AlphaCompLabs/H-Drop/README.md

<div align="center">

# H-DROP

### Veículo de Superfície Autônomo para Logística Humanitária

<br>

<p>
  
  &nbsp;&nbsp;
  
  &nbsp;&nbsp;
  
  <br><br>
  
  &nbsp;&nbsp;
  
  &nbsp;&nbsp;
  
  &nbsp;&nbsp;
  
</p>

<p>
  <strong>Projeto H-DROP · Relatório PC1 · 2026</strong>
</p>

</div>

---

## Sobre o Projeto

O **H-DROP** é um **Veículo de Superfície Autônomo (ASV)** do tipo catamarã, dundamentado no conceito de Dual-use: uma plataforma versátil projetada para atuar na logística humanitária — atendendo populações isoladas e cenários pós-desastre — e no delivery comercial de última milha (last-mile) em canais urbanos e condomínios náuticos. A embarcação é tracionada por propulsão diferencial via **motores brushless** e gerenciada por um sistema embarcado **ESP32** sob o sistema operacional de tempo real FreeRTOS, garantindo processamento assíncrono para navegação autônoma e telemetria via rede **4G LTE**. A infraestrutura de controle opera como uma Estação de Controle de Missão (GCS), permitindo o monitoramento tático de subsistemas e o despacho dinâmico de waypoints através de uma arquitetura baseada em **FastAPI e Angular**.

### Objetivos

- **Versatilidade Operacional (Dual-use):** Automatizar o transporte aquático de cargas, alternando entre o suporte emergencial de insumos vitais e a distribuição comercial rotineira por rotas programáveis.
- **Monitoramento e Consciência Situacional:** Implementar o rastreio em tempo real de coordenadas GNSS, proa magnética absoluta e telemetria energética baseada em Lógica Fuzzy e Contagem de Coulomb.
- **Gestão Logística Inteligente:** Validar o ciclo completo de entrega através de detecção binária de carga e fornecer uma interface tática (Mission Control) otimizada para dispositivos móveis em campo.
- **Segurança e Confiabilidade:** Mitigar riscos operacionais via sistemas de proteção anticolisão e protocolos de preservação de hardware, garantindo a integridade da carga e a estabilidade do sistema sob perturbações ambientais.

---

## Arquitetura da Solução

O sistema é composto por três camadas independentes que se comunicam via protocolo MQTT e WebSocket:

```
├── 📁 BackEnd
│   ├── 📁 src
│   │   ├── 📁 api
│   │   │   ├── 📁 v1
│   │   │   │   ├── 📁 routes
│   │   │   │   │   ├── 🐍 __init__.py
│   │   │   │   │   ├── 🐍 comando.py
│   │   │   │   │   ├── 🐍 health.py
│   │   │   │   │   └── 🐍 telemetria.py
│   │   │   │   ├── 🐍 __init__.py
│   │   │   │   └── 🐍 router.py
│   │   │   └── 🐍 __init__.py
│   │   ├── 📁 core
│   │   │   ├── 🐍 __init__.py
│   │   │   ├── 🐍 config.py
│   │   │   ├── 🐍 lifespan.py
│   │   │   └── 🐍 logging.py
│   │   ├── 📁 models
│   │   │   └── 🐍 __init__.py
│   │   ├── 📁 schemas
│   │   │   ├── 🐍 __init__.py
│   │   │   ├── 🐍 comando.py
│   │   │   └── 🐍 telemetria.py
│   │   ├── 📁 services
│   │   │   ├── 🐍 __init__.py
│   │   │   ├── 🐍 mqtt_service.py
│   │   │   ├── 🐍 telemetria_service.py
│   │   │   └── 🐍 websocket_manager.py
│   │   ├── 📁 utils
│   │   │   ├── 🐍 __init__.py
│   │   │   ├── 🐍 geo.py
│   │   │   └── 🐍 sensores.py
│   │   └── 🐍 __init__.py
│   ├── ⚙️ .env.example
│   ├── ⚙️ .gitignore
│   ├── 📝 README.md
│   ├── 🐍 main.py
│   └── 📄 requirements.txt
├── 📁 Controler-Simulation
│   ├── 📁 .devcontainer
│   ├── 📁 .vscode
│   │   ├── {} c_cpp_properties.json
│   │   ├── {} launch.json
│   │   └── {} settings.json
│   ├── 📁 main
│   │   ├── 🔺 CMakeLists.txt
│   │   ├── 🅒 main.c
│   │   └── 📝 README.md
│   ├── 🔺 CMakeLists.txt
│   ├── 🌐 dashboard.html
│   ├── 🐍 hdrop_sim.py
│   └── 📝 PIPELINE.md
├── 📁 Docs
│   ├── 📕 REACT LIVRO.pdf
│   ├── 📝 README.md
│   ├── 📕 Relatório PC1.pdf
│   ├── 📕 Subsistema_Comunicação_Posicionamento_Módulo_4G_GNSS_TCC.pdf
│   ├── 📕 Subsistema_Controlador_TCC (1).pdf
│   ├── 📕 Subsistema_de_Alimentação_TCC (1).pdf
│   ├── 🖼️ WhatsApp Image 2026-03-01 at 10.31.07.jpeg
│   └── 📕 roteiro_proposta_projeto.pdf
├── 📁 FrontEnd
│   ├── 📁 .angular
│   ├── 📁 src
│   │   ├── 📁 app
│   │   │   ├── 📁 core
│   │   │   │   ├── 📁 models
│   │   │   │   │   ├── 📄 alerta.model.ts
│   │   │   │   │   ├── 📄 comando.model.ts
│   │   │   │   │   ├── 📄 status.model.ts
│   │   │   │   │   └── 📄 telemetria.model.ts
│   │   │   │   └── 📁 services
│   │   │   │       ├── 📄 alerts.service.ts
│   │   │   │       ├── 📄 comando.service.ts
│   │   │   │       ├── 📄 geo.util.ts
│   │   │   │       ├── 📄 telemetria.service.ts
│   │   │   │       └── 📄 theme.service.ts
│   │   │   ├── 📁 features
│   │   │   │   ├── 📁 map
│   │   │   │   │   ├── 🎨 map.component.scss
│   │   │   │   │   └── 📄 map.component.ts
│   │   │   │   ├── 📁 mission-control
│   │   │   │   │   ├── 🎨 mission-control.component.scss
│   │   │   │   │   └── 📄 mission-control.component.ts
│   │   │   │   ├── 📁 sidebar
│   │   │   │   │   ├── 🎨 sidebar.component.scss
│   │   │   │   │   └── 📄 sidebar.component.ts
│   │   │   │   └── 📁 sync-test
│   │   │   │       ├── 🎨 sync-test.component.scss
│   │   │   │       └── 📄 sync-test.component.ts
│   │   │   ├── 📁 shared
│   │   │   │   └── 📁 components
│   │   │   │       ├── 📁 alert-overlay
│   │   │   │       │   ├── 🎨 alert-overlay.component.scss
│   │   │   │       │   └── 📄 alert-overlay.component.ts
│   │   │   │       ├── 📁 compass
│   │   │   │       │   ├── 🎨 compass.component.scss
│   │   │   │       │   └── 📄 compass.component.ts
│   │   │   │       ├── 📁 status-bar
│   │   │   │       │   ├── 🎨 status-bar.component.scss
│   │   │   │       │   └── 📄 status-bar.component.ts
│   │   │   │       ├── 📁 telemetry-card
│   │   │   │       │   ├── 🎨 telemetry-card.component.scss
│   │   │   │       │   └── 📄 telemetry-card.component.ts
│   │   │   │       └── 📁 theme-toggle
│   │   │   │           └── 📄 theme-toggle.component.ts
│   │   │   ├── 📄 app.component.ts
│   │   │   ├── 📄 app.config.ts
│   │   │   └── 📄 app.routes.ts
│   │   ├── 📁 assets
│   │   │   ├── 📁 favicon
│   │   │   │   └── 📝 README.md
│   │   │   └── 📁 images
│   │   │       ├── 📝 README.md
│   │   │       ├── 🖼️ logo-hdrop-dark.png
│   │   │       └── 🖼️ logo-hdrop-light.png
│   │   ├── 📁 environments
│   │   │   ├── 📄 environment.prod.ts
│   │   │   └── 📄 environment.ts
│   │   ├── 🌐 index.html
│   │   ├── 📄 main.ts
│   │   └── 🎨 styles.scss
│   ├── ⚙️ .gitignore
│   ├── 📝 README.md
│   ├── ⚙️ angular.json
│   ├── ⚙️ package-lock.json
│   ├── ⚙️ package.json
│   ├── ⚙️ tsconfig.app.json
│   └── ⚙️ tsconfig.json
├── 📁 GPS
│   ├── 📝 README.md
│   └── 📄 hdrop_barco_autonomo.ino
├── 📁 Motors-Simulation
│   └── 📄 firmware-motores.ino
├── 📁 Sensor
│   ├── 📁 include
│   │   └── 📄 README
│   ├── 📁 lib
│   │   └── 📄 README
│   ├── 📁 src
│   │   └── ⚡ main.cpp
│   ├── 📁 test
│   │   └── 📄 README
│   ├── ⚙️ .gitignore
│   ├── 📝 README.md
│   └── ⚙️ platformio.ini
└── 📝 README.md
```

### Fluxo de Dados

```
┌──────────────┐      MQTT       ┌──────────────┐    WebSocket    ┌──────────────┐
│   ESP32      │ ─────────────▶  │   Backend    │ ──────────────▶ │   Angular    │
│   + GNSS     │   hdrop/raw     │   FastAPI    │  /ws/telemetria │   Dashboard  │
│   + Magnet.  │ ◀─────────────  │   (Hub)      │ ◀────────────── │   (Operador) │
└──────────────┘  hdrop/comando  └──────────────┘   POST /comando └──────────────┘
                                         │
                                         ▼
                                 hdrop/telemetria
                                 (eco processado)
```

1. O ESP32 publica telemetria bruta (string NMEA + vetor do magnetômetro) no tópico **`hdrop/raw`**.
2. O backend processa em tempo real — calcula a proa calibrada e extrai coordenadas GPS — e re-publica o resultado limpo em **`hdrop/telemetria`**, simultaneamente fazendo broadcast via **WebSocket** para todos os operadores conectados.
3. O operador clica no mapa, o frontend envia **`POST /api/v1/comando`** ao backend, que publica a coordenada em **`hdrop/comando`** — o ESP32 recebe e recalcula a rota.

---

## Subsistemas Monitorados (Relatório PC1)

| Subsistema | Hardware | Responsabilidade |
|:---|:---|:---|
| **Controle Embarcado** | ESP32 | Orquestração de sensores, atuação dos motores, comunicação MQTT |
| **Posicionamento** | GNSS + A7670SA | Geolocalização via constelação de satélites + fix assistido |
| **Comunicação** | A7670SA (4G LTE) | Uplink de telemetria e downlink de comandos através de broker MQTT |
| **Navegação** | Magnetômetro calibrado | Determinação de proa magnética (0°–360°) |
| **Propulsão** | 2× motores brushless | Controle diferencial para avanço, ré e curvas |
| **Energia** | LiFePO4 + INA226 | Monitoramento de tensão, corrente e SoC da bateria |
| **Carga Útil** | Célula de carga HX711 | Detecção de compartimento ocupado/vazio |

---

## Início Rápido

### Pré-requisitos

- **Python 3.11+** e pip
- **Node.js 20+** e npm
- Conexão à internet (para alcançar o broker público `broker.hivemq.com`)

### 1. Iniciar o Backend

```bash
cd BackEnd
python -m venv venv
venv\Scripts\activate          # Windows
# source venv/bin/activate     # Linux/macOS
pip install -r requirements.txt
copy .env.example .env         # Windows
# cp .env.example .env         # Linux/macOS
python main.py
```

API disponível em **`http://localhost:8000`** · Swagger em **`http://localhost:8000/docs`**

### 2. Iniciar o Frontend

```bash
cd FrontEnd
npm install
npm start
```

Mission Control disponível em **`http://localhost:4200`**

### 3. Simular Telemetria do ESP32 (opcional)

Sem o hardware em mãos, você pode publicar mensagens diretamente no broker usando `mosquitto_pub` ou qualquer cliente MQTT:

```bash
mosquitto_pub -h broker.hivemq.com -t hdrop/raw \
  -m '{"g":",,,,,-15.87500,S,-48.08500,W,...","m":[1700,150,0]}'
```

O dashboard deve atualizar a posição e a proa em tempo real.

### 4. Executar a Simulação do Controlador

O módulo `Controler-Simulation` permite validar a lógica de navegação e controle PID sem o hardware embarcado. Requer o ESP-IDF instalado e configurado.

```bash
cd Controler-Simulation
idf.py build
idf.py flash monitor   # com hardware conectado
# ou execute hdrop_sim.py para simulação em Python
python hdrop_sim.py
```

O dashboard de simulação pode ser acessado abrindo `dashboard.html` diretamente no navegador. Consulte `PIPELINE.md` para detalhes do fluxo de simulação.

### 5. Carregar o Firmware dos Motores

O módulo `Motors-Simulation` contém o firmware de controle dos ESCs para validação da propulsão diferencial via interface web, desenvolvido no Arduino IDE.

```
Pré-requisitos:
- Arduino IDE 2.x
- Biblioteca ESP32Servo instalada (Gerenciador de Bibliotecas)
- Placa: ESP32 Dev Module
```

```bash
# 1. Abra o arquivo no Arduino IDE:
Motors-Simulation/firmware-motores.ino

# 2. Edite as credenciais Wi-Fi no início do arquivo:
const char* ssid     = "NOME_DA_SUA_REDE";
const char* password = "SENHA_DA_SUA_REDE";

# 3. Selecione a porta COM correta e faça o upload
```

Após o upload, o IP do ESP32 será exibido no Serial Monitor. Acesse esse IP pelo navegador do celular (na mesma rede) para controlar os motores individualmente via sliders PWM ou pelos botões de ré, frente e parada de emergência.

---

## Stack Tecnológica

| Camada | Tecnologia | Versão |
|:---|:---|:---|
| Framework Backend | FastAPI | 0.115+ |
| Cliente MQTT Assíncrono | aiomqtt | 2.3+ |
| Servidor ASGI | Uvicorn | 0.32+ |
| Validação de Dados | Pydantic | 2.10+ |
| Configuração | pydantic-settings | 2.7+ |
| Framework Frontend | Angular | 19+ |
| Linguagem | TypeScript | 5.6+ |
| Biblioteca de Mapas | Leaflet | 1.9+ |
| Ícones | Iconify (Phosphor Icons) | 2.1+ (via CDN) |
| Reatividade | RxJS + Angular Signals | — |
| Broker MQTT | HiveMQ (público) | — |
| Firmware Motores | Arduino IDE + ESP32Servo | 2.x |
| Simulação Controlador | ESP-IDF + Python | 5.x / 3.11+ |

---

## Identidade Visual (PC1)

A paleta **Mission Control** foi derivada do Relatório PC1 e pensada para leitura rápida em situações críticas:

| Token | Cor | Uso |
|:---|:---:|:---|
| **Critical Ocean Blue** | `#0a4d8c` | Interface principal, mapas, destaques |
| **Life-Saving Green** | `#00d66b` | Estados OK, bateria cheia, missão concluída |
| **Safety Yellow** | `#ffc233` | Avisos, proximidade de obstáculos, sync pendente |
| **Strategic Red** | `#ff3b3b` | Erros críticos, parada de emergência, bateria crítica |

Dois temas disponíveis via toggle no header: **Mission Dark** (padrão, otimizado para cabines de controle) e **Utility Light** (otimizado para luz solar direta em campo).

---

## Funcionalidades

| Status | Funcionalidade |
|:---:|:---|
| ✓ | Telemetria GPS em tempo real com suavização (média móvel de 5 pontos) |
| ✓ | Cálculo assíncrono da proa magnética com calibração de offsets |
| ✓ | Mapa Leaflet interativo com 3 camadas (dark/street/satellite) |
| ✓ | Envio de waypoints por clique no mapa (publish MQTT) |
| ✓ | WebSocket broadcast para múltiplos operadores simultâneos |
| ✓ | Dashboard responsivo com abas mobile (mapa/telemetria/sync) |
| ✓ | Aba Sync Test com comandos rápidos (START/ACK/HOME/STOP) |
| ✓ | Sistema de alertas críticos com modal bloqueante |
| ✓ | Troca dinâmica Mission Dark / Utility Light |
| ✓ | Firmware de validação da propulsão diferencial via interface web (Motors-Simulation) |
| ✓ | Simulação do controlador embarcado com dashboard e pipeline de testes (Controler-Simulation) |
| ○ | Persistência de histórico de missões (MongoDB — roadmap Fase 3) |
| ○ | Monitoramento do SoC da bateria via INA226 (firmware em desenvolvimento) |
| ○ | Detecção de carga via HX711 (firmware em desenvolvimento) |
| ○ | Autenticação e perfis de operador (roadmap) |

---

## Documentação por Módulo

| Módulo | Documentação |
|:---|:---|
| **Backend — API FastAPI + MQTT** | [BackEnd/README.md](./BackEnd/README.md) |
| **Frontend — Mission Control Angular** | [FrontEnd/README.md](./FrontEnd/README.md) |
| **Simulação do Controlador** | [Controler-Simulation/main/README.md](./Controler-Simulation/main/README.md) |
| **Firmware dos Motores** | [Motors-Simulation/](./Motors-Simulation/) |
| **Relatório PC1 e subsistemas** | [Docs/](./Docs/) |

---

<div align="center">
  <br>
  &copy; 2026 Projeto H-DROP. Todos os direitos reservados.
  <br><br>
  <em>Autonomous Surface Vehicle · Humanitarian Logistics · Mission Control</em>
</div>
