AlphaCompLabs/H-Drop/Docs/Subsistema_Controlador_TCC (1).pdf

# Subsistema Controlador

1

° Diogo Freitas Machado
Engenharia de Computaçaõ
Instituto de Educaçao Superior de Bras ˜ | ília - IESB
Brasília, DF
diogo.machado@iesb.edu.br
2312082012

2

° Elisa Nunes de Freitas
Engenharia de Computaçaõ
Instituto de Educaçao Superior de Bras ˜ | ília - IESB
Brasília, DF
elisa.freitas@iesb.edu.br
2312082040

Orientador: Paulo Henrique Moreira de Carvalho Faria
Engenharia Eletronica & Engenharia de Software ˆ
Instituto de Educaçao Superior de Bras ˜ | ília - IESB
Brasília, DF
paulo.faria@iesb.edu.br
201836
Abstract—Este documento e uma formalizaç ´ | ao das pesquisas ˜
realizadas sobre tudo o que tange a respeito do ESP32 (Controlador) para o ASV a ser desenvolvido.
Index Terms—Controle, Atuadores, ESP32, motores, RIPEAM
I. INTRODUÇ AO E ˜ ESCOPO

Uma vez estruturado o Subsistema de Alimentaçao, o ˜ proximo passo definido para o desenvolvimento do ASV foi a ´ pesquisa e estruturaçao dos subsistemas de processamento do ˜ dispositivo. O presente documento abordara especificamente ´ sobre o Subsistema Controlador e tudo o que tange a seu respeito. Dessa forma, para este documento, mencionar subsistema controlador entende-se por todas as responsabili-
dades , atuaçoes e conex ˜ | oes do ESP32 escolhido para ser o ˜
responsavel por controlar os atuadores do ASV, como motores ´ e LEDs de segurança.

II. HARDWARE DO CONTROLADOR (ESP32)
Antes de aprofundar nas responsabilidade, conexoes, etc ˜ | é
necessario conhecer o microcontrolador selecionado e suas ´ características. Sendo assim, o ESP32 foi escolhido com base nos criterios de custo, acessibilidade, facilidade de ´
implementaçao/integraç ˜ | ao e capacitaç ˜ | ao para os requisitos do ˜
projeto.
A. ESP32-WROOM-32
E o microcontrolador que suprir ´ | a todos os crit ´ | erios do ´
projeto planejado visto que ele possui um custo baixo, é um dos microcontroladores mais difundidos na comunidade
e e um m ´ | odulo poderoso e gen ´ | erico de MCU com Wi-Fi, ´
Bluetooth e Bluetooth LE alem do n ´ | ucleo deste m ´ | odulo ´
com o chip ESP32-D0WDQ6, que possui dois processadores Xtensa® de 32 bits LX6 os quais podem operar a uma
frequencia de at ˆ | e 240 MHz. ´

Principais Componentes

- Processador e Memoria: ´ O modulo conta com micro- ´ processadores dual-core Xtensa® 32-bit LX6, 448 KB de ROM, 520 KB de SRAM e 8 KB de SRAM no RTC.
Alem disso, possui 4 MB de mem ´ | oria flash SPI externa ´
integrada.
- Perifericos Integrados: ´ | O modulo disp ´ | oe de uma vasta ˜
gama de perifericos, incluindo: ´

– Ate 32 GPIOs. ´
– Interfaces como UART, SPI, SDIO, I2C, I2S e LED PWM.
– Sensores como sensor de toque capacitivo, sensor Hall, ADC (Conversor Analogico-Digital) e DAC ´ (Conversor Digital-Analogico). ´
– Contador de pulsos e controlador TWAI® (compatível com ISO 11898-1, especificaçao CAN 2.0). ˜ – Interface Ethernet MAC para comunicaçoes LAN. ˜
- Relogio e Cristal: ´ | Possui um oscilador de cristal de 40
MHz integrado.

Por fim, este ESP possui algumas funcionalidades de destaque como Gerenciamento de Energia com diferentes modos de energia, Segurança e Boot com pinos de strapping e
bits eFuse alem de possuir uma gama variada de aplicaç ´ | | oes.E ˜
de todos estes componentes e funcionalidades, os mais utiliza-
dos neste sistema serao o perif ˜ | erico MCPWM, o perif ´ | erico ´
LEDC, as interfaces UART, a interface I2C, os GPIOs e principalmente os nucleos processadores Xtensa®. ´

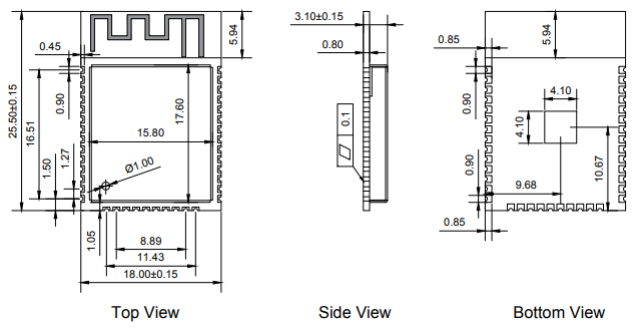
[picture p17: figure]

Fig. 1: Dimensoes do ESP32-WROOM-32 ˜

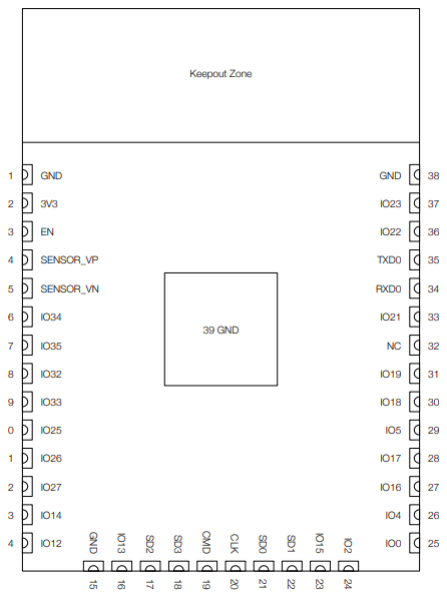
[picture p18: figure]

Fig. 2: Layout de Pinos do ESP32-WROOM-32

Observaçao.: ˜ Pretende-se utilizar o ESP32 ja no modelo ´ DEV KIT em uma placa PCB para maior simplicidade do projeto.

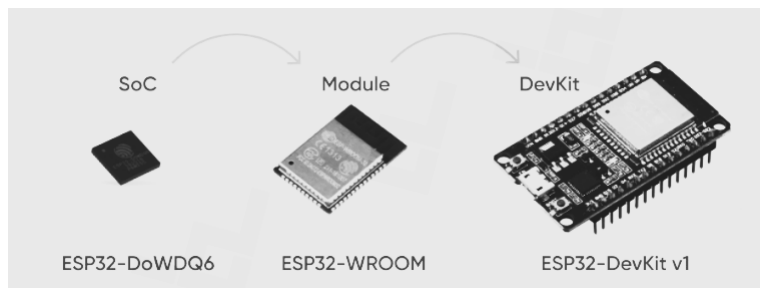
[picture p19: figure]

Fig. 3: Explicaçao visual do DEV KIT ˜

B. Restriçoes de Hardware e Seleç ˜ | ao Segura de GPIOs ˜
Embora o ESP32 ofereça uma ampla gama de pinos de entrada e saída (GPIOs), a seleçao para o controle de atu- ˜ adores críticos (como motores e luzes RIPEAM) nao pode ˜
ser arbitraria. Existem grupos de pinos com funç ´ | oes especiais ˜
de inicializaçao ( ˜ | boot) e restriçoes el ˜ | etricas que, se ignoradas, ´
podem impedir a inicializaçao do sistema ou causar falhas ˜ intermitentes.

Pinos de Strapping (Strapping Pins): O ESP32 possui 5 pinos de strapping: GPIO 0, 2, 5, 12 e 15. Durante a
inicializaçao (fase de ˜ | Power-On Reset), o chip amostra o nível
de tensao nestes pinos para decidir par ˜ | ametros cr ˆ | íticos:
- Modo de Boot: O GPIO 0 deve estar em nível ALTO para iniciar o firmware normalmente. Se estiver BAIXO,
o chip entra em modo de gravaçao ( ˜ | Download Mode).
- Tensao da Flash (VDD ˜ | SDIO): O GPIO 12 controla
a tensao do regulador interno (1.8V ou 3.3V). Se um ˜ circuito externo puxar este pino para o nível errado durante o boot, o processador pode sofrer Brownout e nao iniciar. ˜
- Logs de Debug: O GPIO 15 controla as mensagens de log na serial durante o boot.
Devido a essas características, o projeto do subsistema de controle evitou conectar drivers de baixa impedancia ou ˆ resistores de pull-up/pull-down fortes nestes pinos, priorizando o uso de GPIOs ”seguros” (como 16, 17, 18, 19 e 21 a 23) para o controle dos motores e comunicaçao. ˜
Pinos de Entrada Exclusiva (Input-Only): Os pinos GPIO 34, 35, 36 (VP) e 39 (VN) nao possuem circuitos ˜ de saída push-pull, funcionando apenas como entradas digitais ou analogicas. No projeto, estes pinos foram reservados ´ estritamente para leitura de sensores (como monitoramento de tensao da bateria via ADC), evitando seu uso para controle de ˜ LEDs ou ativaçao de MOSFETs. ˜
Pinos Reservados a Flash SPI ` | : Os pinos GPIO 6 ao
11 estao conectados internamente ˜ | a mem ` | oria Flash integrada ´
do modulo ESP32-WROOM-32. O uso destes pinos para ´ qualquer periferico externo causaria conflito no barramento ´ SPI, travando o sistema imediatamente.

TABLE I: Mapeamento de Segurança dos GPIOs Selecionados

Grupo | GPIOs | Decisao de Projeto ˜
Strapping | 0, 2, 5, 12, 15 | Evitados para saídas críticas (PWM/Mo-tores) para garantir boot seguro.
Flash SPI | 6 – 11 | Nao utilizados ˜ (Conectados a mem ` oria ´ flash interna).
Input Only | 34 – 39 | Reservados estritamente para Sensores (AD-C/Feedback).
Safe I/O | 16, 17, 18, 19 | Alocados para perifericos ativos (UART, ´ PWM e RIPEAM).
III. ALIMENTAÇ AO E ˜ | PROTEÇ AÕ ELETRICA ´
Atraves | dos | reguladores | Buck do | Subsistema | de ´
Alimentaçao, ser ˜ | a feita a conex ´ | ao ao pino de alimentaç ˜ | aõ
(Vin) OU diretamente ao pino de 3V3 que permitira a ativaç ´ | aõ
e funcionamento constanste do ESP32.

IV. ARQUITETURA DE SOFTWARE (RTOS)

Diferentemente de arquiteturas de super-loop (execuçaõ sequencial unica) comuns em microcontroladores de 8 bits, o ´ subsistema de controle do ASV exige a execuçao concorrente ˜ de tarefas com requisitos temporais distintos: a malha de controle PID deve ser estritamente determinística, enquanto
a interpretaçao de comandos via UART ˜ | e orientada a eventos ´
e assíncrona.

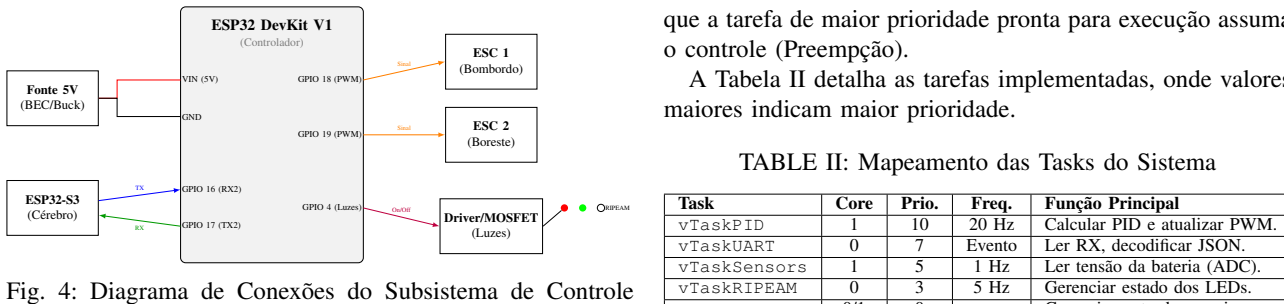
[picture p20: figure]
ESP32 DevKit V1; (Controlador); VIN (5V); GND; GPIO 16 (RX2); GPIO 17 (TX2); GPIO 18 (PWM); GPIO 19 (PWM); GPIO 4 (Luzes); Fonte 5V (BEC/Buck); ESP32-S3 (Cerebro) ´; ESC 1 (Bombordo) Sinal; ESC 2 (Boreste); Sinal; Driver/MOSFET (Luzes); On/Off; RIPEAM; o controle (Preempçao). ˜; maiores indicam maior prioridade.; Task; Core; Prio.; Freq.; Funçao Principal ˜; vTaskPID; Calcular PID e atualizar PWM.; vTaskUART; Evento; Ler RX, decodificar JSON.; vTaskRIPEAM; Gerenciar estado dos LEDs.

Fig. 4: Diagrama de Conexoes do Subsistema de Controle ˜ (DevKit).

Para gerenciar essa complexidade, utiliza-se o FreeRTOS (Real-Time Operating System), nativo do framework de desenvolvimento do ESP32. O sistema operacional gerencia o escalonamento das tarefas (Tasks), permitindo preempçaõ baseada em prioridades e o uso eficiente dos dois nucleos de ´ processamento do ESP32-D0WDQ6.

A. Estrategia de Multiprocessamento Assim ´ | | etrico (AMP) ´
O ESP32 possui dois nucleos Xtensa® LX6 de 32 bits. ´ Para maximizar a estabilidade da navegaçao, adotou-se uma ˜
estrategia de segregaç ´ | ao de responsabilidades: ˜
- Core 0 (Protocol CPU - PRO CPU): Dedicado as` tarefas de ”infraestrutura” e comunicaçao. Ele gerencia ˜ a pilha Wi-Fi/Bluetooth (se ativa), o monitoramento do sistema (Watchdog) e o processamento de pacotes da
UART. Interrupçoes de comunicaç ˜ | ao s ˜ | ao tratadas aqui ˜
para nao inserir ˜ | jitter (ruído temporal) no controle.
- Core 1 (Application CPU - APP CPU): Dedicado
exclusivamente a matem ` | atica de controle e atuaç ´ | ao. A ˜
Task do PID roda isolada neste nucleo, garantindo que ´ o calculo das integrais e derivadas ocorra em intervalos ´ precisos (Ts = 50ms), imune a atrasos causados pelo processamento de strings ou logs de sistema.
A Figura 5 ilustra essa distribuiçao de carga. ˜

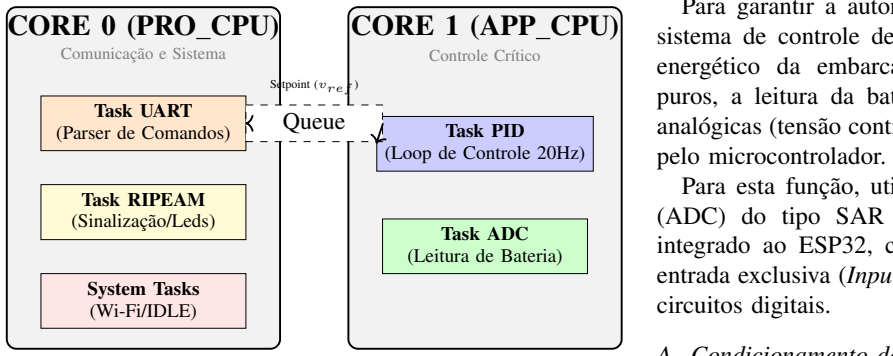
[picture p21: figure]
CORE 0 (PRO CPU); Comunicaçao e Sistema ˜; Task UART (Parser de Comandos); Task RIPEAM (Sinalizaçao/Leds) ˜; System Tasks (Wi-Fi/IDLE); CORE 1 (APP CPU); Controle Crítico; Task PID (Loop de Controle 20Hz); Task ADC (Leitura de Bateria); Queue; Setpoint (vref ); pelo microcontrolador.; circuitos digitais.

Fig. 5: Arquitetura de Software: Alocaçao de tarefas nos ˜ nucleos do ESP32. ´

B. Definiçao e Priorizaç ˜ | ao de Tarefas ˜
No FreeRTOS, a prioridade determina qual tarefa tem
preferencia de uso da CPU. O escalonador ( ˆ | Scheduler) garante

que a tarefa de maior prioridade pronta para execuçao assuma ˜

A Tabela II detalha as tarefas implementadas, onde valores

TABLE II: Mapeamento das Tasks do Sistema

vTaskSensors | 1 | 5 | 1 Hz | Ler tensao da bateria (ADC). ˜
IDLE | 0/1 | 0 | - | Gerenciamento de energia.
A vTaskPID | possui a prioridade mais alta no
Core 1 para garantir determinismo. Utiliza-se a funçaõ vTaskDelayUntil() para assegurar que o período de amostragem seja exato, compensando o tempo de execuçaõ
do proprio algoritmo matem ´ | atico. ´
C. Sincronizaçao e Comunicaç ˜ | ao Inter-Processos (IPC) ˜
Como as tarefas rodam em nucleos diferentes, elas n ´ | ao po- ˜
dem simplesmente acessar variaveis globais simultaneamente ´
sem risco de corrupçao de mem ˜ | oria ( ´ | Race Condition).
A troca de dados entre a recepçao de comandos (Core 0) e ˜
o controle (Core 1) e realizada atrav ´ | es de ´ | Filas do FreeRTOS
(Queues).
1) Quando a vTaskUART recebe um novo comando
de | velocidade, | ela | ”posta” | o | valor | na | fila
xQueueSetpoint.
2) No início de cada ciclo, a vTaskPID verifica se há novos dados na fila.
3) Se houver, atualiza a referencia ( ˆ | SP); se nao, mant ˜ | em´
a anterior e executa o calculo. ´
Este mecanismo desacopla os tempos de execuçao: o sis- ˜ tema pode receber varios comandos via Serial sem interromper ´ a geraçao suave de PWM para os motores. ˜
V. AQUISIÇ AO DE ˜ | DADOS (SENSORES E ADC)

Para garantir a autonomia e a segurança do ASV, o subsistema de controle deve monitorar continuamente o estado
energetico da embarcaç ´ | | ao. Diferente de sistemas digitais ˜
puros, a leitura da bateria exige a conversao de grandezas ˜
analogicas (tens ´ | ao cont ˜ | ínua) para valores digitais processaveis ´
Para esta funçao, utiliza-se o conversor Anal ˜ | ogico-Digital ´
(ADC) do tipo SAR (Successive Approximation Register) integrado ao ESP32, configurado para operar nos pinos de entrada exclusiva (Input-Only), minimizando interferencias de ˆ
A. Condicionamento de Sinal (Hardware)
A bateria Li-Po 4S utilizada no projeto possui tensao nom- ˜
inal de 14.8V e tensao de carga m ˜ | axima de ´ | 16.8V . Como os
pinos do ESP32 toleram no maximo ´ | 3.3V (ou 3.6V absolutos),
a conexao direta ˜ | e destrutiva. ´
Implementou-se um circuito divisor de tensao resistivo para ˜ atenuar o sinal de entrada para uma faixa segura (0 a 3V),

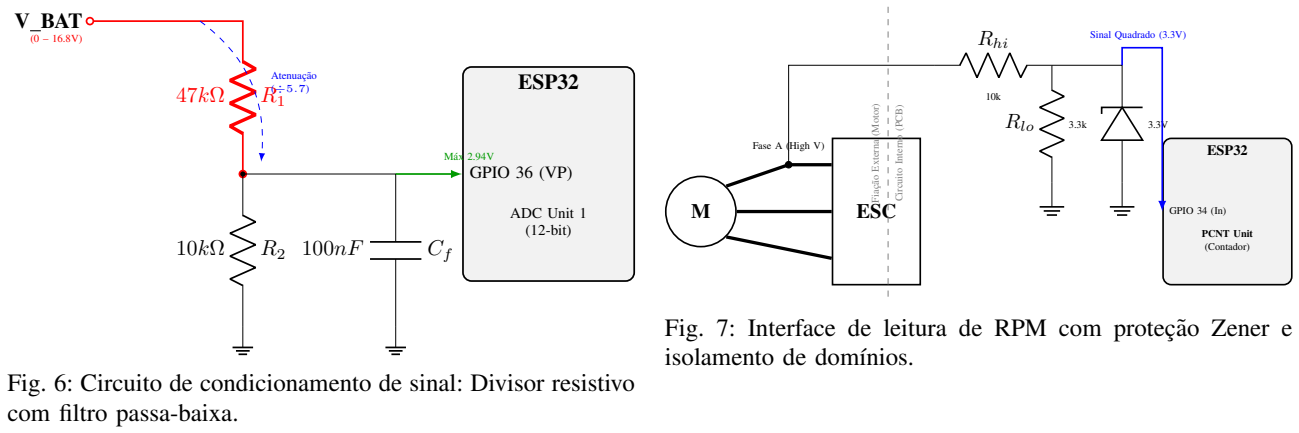
[picture p22: figure]
ESP32; ADC Unit 1 (12-bit); GPIO 36 (VP); V BAT; Atenuaçaõ (÷5.7); Max 2.94V ´; com filtro passa-baixa.; M ESC; Fase A (High V); PCNT Unit (Contador); GPIO 34 (In); Rhi; Rlo; Sinal Quadrado (3.3V); Fiação Externa (Motor); Circuito Interno (PCB); isolamento de domínios.

Fig. 6: Circuito de condicionamento de sinal: Divisor resistivo

preservando a resoluçao do ADC. A topologia do circuito ˜ | é
ilustrada na Figura 6.
A relaçao de tens ˜ | aõ e dada por: ´

Vadc = Vbat ·

R2
R1 + R2

(1)

Utilizando R1 = 47kΩ e R2 = 10kΩ, obtem-se um fator ´ de divisao de ˜ ≈ 0.175. Para Vbat = 16.8V , a tensao no pino ˜ será 2.94V , o que esta dentro da faixa linear segura do ADC ´
com atenuaçao de 11dB. O capacitor ˜ | | | Cf atua como um filtro
passa-baixa passivo de primeira ordem, eliminando ruídos de alta frequencia provenientes dos motores. ˆ
B. Feedback de Propulsao (Tacometria) ˜

O controle PID de velocidade exige a realimentaçao da ˜ rotaçao real (RPM) dos propulsores. Considerando que mo- ˜ tores Brushless (BLDC) de aplicaçao n ˜ autica frequentemente ´ operam na configuraçaõ Sensorless (sem sensores Hall integra-
dos), a estrategia de leitura baseia-se na detecç ´ | ao da frequ ˜ | encia ˆ
de comutaçao el ˜ | etrica das fases. ´
A tecnica empregada consiste no monitoramento de uma das ´
tres fases de alimentaç ˆ | ao do motor. O sinal de tens ˜ | ao nesta fase ˜
e uma onda trapezoidal ou senoidal cuja frequ ´ | encia ( ˆ | fpulso) é
proporcional a rotaç ` | ao mec ˜ | anica, dada pela relaç ˆ | ao: ˜

RPM =

fpulso × 60

Npolos/2

(2)

Onde Npolos e o n ´ | umero de polos magn ´ | eticos do rotor. ´
Para interfacear este sinal de alta tensao (que oscila entre ˜ 0V e a tensao da bateria, ex: 14.8V) com o ESP32 (3.3V), ˜ projetou-se um circuito condicionador com acoplamento resistivo e proteçaõ Zener, conforme ilustrado na Figura 7.
O divisor resistivo (Rhigh/Rlow) reduz a amplitude da
tensao da fase para n ˜ | íveis compatíveis com a logica digital, ´
enquanto o diodo Zener de 3.3V atua como clamping, protegendo o pino do ESP32 contra picos de tensao indutiva comuns ˜ em cargas motrizes. O sinal resultante e uma onda quadrada ´ limpa, cuja frequencia ˆ e contabilizada pela unidade PCNT do ´ microcontrolador.

Fig. 7: Interface de leitura de RPM com proteçao Zener e ˜

C. Sensoriamento Ambiental (LDR e RIPEAM)

O sistema de iluminaçao RIPEAM deve operar de forma ˜
autonoma em relaç ˆ | aõ | a luminosidade ambiente. Para isso, `
utiliza-se um sensor foto-resistivo (LDR) conectado a um pino ADC.
A simples leitura do valor de luz naõ e suficiente devido ´
ao fenomeno de oscilaç ˆ | ao na linha de crep ˜ | usculo (p ´ | or do sol), ˆ
onde pequenas variaçoes de sombra poderiam fazer as luzes ˜ ”piscarem”. Para resolver isso, implementou-se uma logica de ´ Histerese de Software baseada no diagrama da Figura 8.

Luminosidade (Lux)

Estado LEDs

Lbaixa (Anoitecer)Lalta (Amanhecer)

Liga Luzes

Desliga Luzes

ZONA DE
HISTERESE
(Estado Mantido)
Fig. 8: Logica de Histerese para evitar oscilaç ´ | ao (flicker) das ˜
luzes de navegaçao. ˜

O algoritmo define dois limiares distintos: um para ligar (Lbaixa < 300 lux) e outro superior para desligar (Lalta > 600 lux). Enquanto a luminosidade estiver na ”Zona de Histerese”, o sistema mantem o estado anterior, garantindo estabilidade ´ operacional.

D. Características e Calibraçao do ADC ˜
O ADC do ESP32 possui resoluçao configur ˜ | avel de at ´ | e 12 ´
bits (2

12 = 4096 valores discretos). No entanto, este compo-
nente e conhecido por sua n ´ | ao-linearidade nas extremidades ˜
da escala (proximo a 0V e 3.3V) e variaç ´ | ao significativa do ˜
Vref (Tensao de Refer ˜ | encia) entre diferentes chips. ˆ
Para mitigar esses erros e obter uma leitura confiavel, ´ adotou-se o seguinte fluxo de processamento digital, detalhado na Figura 9.
1) Tecnicas de Software Empregadas: ´
- Multisampling: A cada ciclo de leitura, o firmware captura 64 amostras consecutivas e calcula a media ´
aritmetica. Isso reduz o ru ´ | ído aleatorio induzido pelos ´
ESCs.

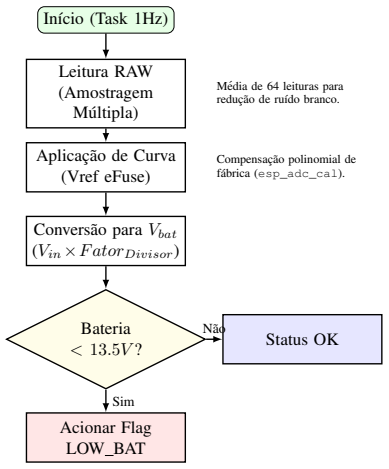
[picture p23: figure]
Início (Task 1Hz); Leitura RAW (Amostragem Multipla) ´; Media de 64 leituras para ´; reduçao de ru ˜; ído branco.; Aplicaçao de Curva ˜ (Vref eFuse); Compensaçao polinomial de ˜; fabrica ( ´; esp_adc_cal).; Conversao para ˜; Vbat; (Vin×F atorDivisor); Bateria < 13.5V ?; Acionar Flag LOW BAT; Status OK; Sim; Naõ
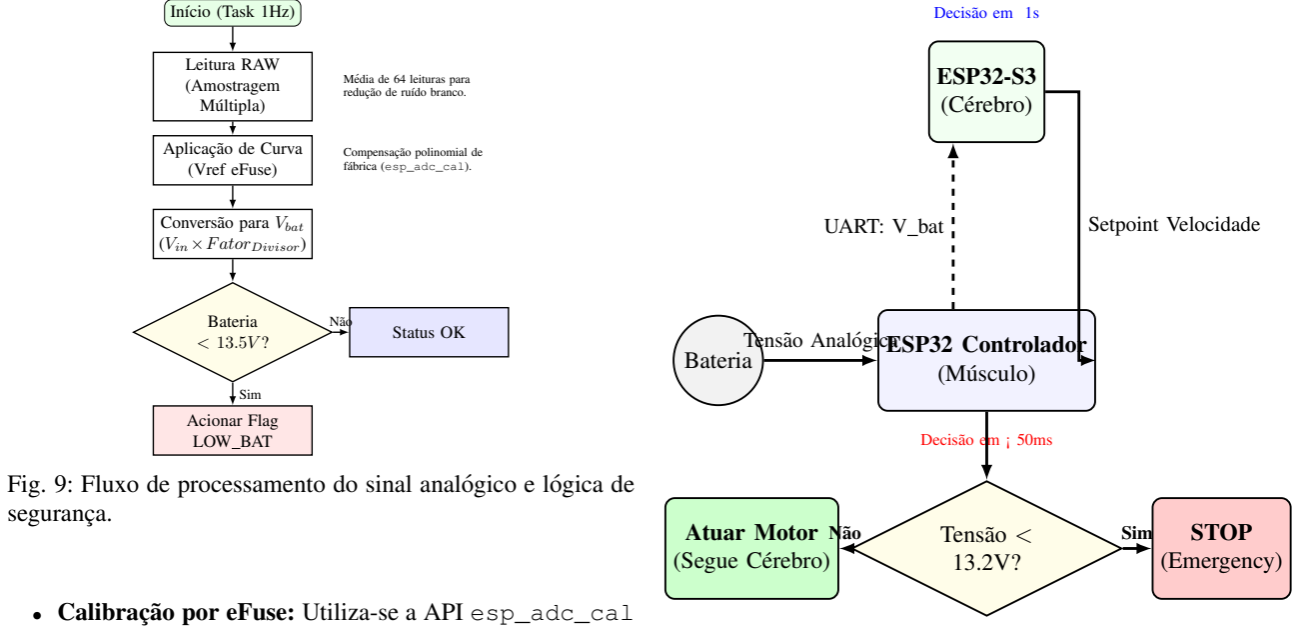
[picture p24: figure]
segurança.; • Calibraçao por eFuse: ˜; Utiliza-se a API esp_adc_cal; ESP32 Controlador (Musculo) ´; Decisao em ¡ 50ms ˜; ESP32-S3 (Cerebro) ´; Decisao em 1s ˜; Bateria; Tensaõ < 13.2V?; STOP (Emergency); Atuar Motor (Segue Cerebro) ´; Tensao Anal ˜; ogica ´; UART: V bat; Setpoint Velocidade; Naõ; Sim

Fig. 9: Fluxo de processamento do sinal analogico e l ´ | ogica de ´
que le os coeficientes de calibraç ˆ | | ao gravados permanen- ˜
temente na memoria eFuse do chip durante a fabricaç ´ | ao, ˜
corrigindo o desvio da tensao de refer ˜ | encia interna ˆ
(1100mV ± 10%).
- Atenuaçao de Hardware: ˜ | | O ADC e configurado com ´
ADC_ATTEN_DB_11, permitindo leituras de escala com-
pleta ate aproximadamente ´ | | 3.1V , cobrindo a saída
maxima do divisor de tens ´ | ao ( ˜ | 2.94V ).
E. Diferenciaçao: Monitoramento de Segurança vs. Gest ˜ | aõ
Energetica ´
E importante aqui, deixar claro a diferença entre a funç ´ | aõ
da leitura de bateria realizada pelo ESP32 Controlador
(”Musculo”) daquela realizada pelo ESP32-S3 (”C ´ | erebro”). ´
Embora ambos utilizem a mesma grandeza física (tensao da ˜
bateria), seus propositos no sistema s ´ | ao distintos e comple- ˜
mentares:
- Nível Tatico (ESP32 Controlador): ´ | Realiza a Proteçaõ
de Hardware. O algoritmo do ADC verificado nesta
seçao atua como um fus ˜ | ível digital de resposta rapida. ´
Se a tensao lida cair abaixo do limiar cr ˜ | ítico de descarga
profunda (Vcrit = 13.2V para Li-Po 4S), o Controlador tem autonomia para ignorar os comandos de velocidade
do Cerebro e forçar a parada dos motores ( ´ | Cut-off),
preservando a integridade química das celulas da bateria. ´
- Nível Estrategico (ESP32-S3): ´ | Realiza a Otimizaçaõ
da Missaõ . O Controlador envia o valor medio de tens ´ | aõ
via UART para o Cerebro. O S3 utiliza este dado para ´ recalcular a autonomia restante e ajustar o Setpoint de velocidade de cruzeiro, garantindo que a energia seja suficiente para completar a rota planejada via GPS.
A Figura 10 ilustra este fluxo de decisao hier ˜ | arquico. ´
Fig. 10: Hierarquia de decisao energ ˜ | etica: O C ´ | erebro otimiza, ´
o Musculo protege. ´

VI. CONTROLADOR PID DIGITAL
Uma das principais responsabilidades do Subsistema Con-
trolador sera a estabilidade de navegaç ´ | ao, essa estabilidade ˜
de navegaçao do ASV depende da capacidade do sistema de ˜
rejeitar disturbios hidrodin ´ | amicos (ondas, correntes) e manter ˆ
a velocidade de referencia ( ˆ | vref ) definida pela estrategia ´
de energia do processador principal. Para tal, implementa-se um compensador Proporcional-Integral-Derivativo (PID) em tempo discreto, executado em tempo real pelo nucleo do ´ ESP32.
A. Discretizaçao do Modelo Matem ˜ | atico ´
A lei de controle classica no dom ´ | ínio contínuo e definida ´
por:

u(t) = Kpe(t) + Ki

Z t

0

e(τ )dτ + Kd

de(t)
dt | (3)
Para implementaçao em microcontrolador, esta equaç ˜ | aõ
deve ser discretizada com um período de amostragem fixo
Ts. Utilizando o metodo de aproximaç ´ | ao retangular para a ˜
integral (Euler) e diferenças finitas para a derivada, obtem-se ´
a equaçao de diferenças para o instante atual ˜ | k:
u[k] = P[k] + I[k] + D[k] | (4)

Onde os termos sao calculados recursivamente: ˜
- Termo Proporcional: P[k] = Kp · e[k]
- Termo Integral: I[k] = I[k − 1] + Ki
- Ts · e[k]
- Termo Derivativo: D[k] = Kd
Ts
- (e[k] − e[k − 1])
O erro e[k] e calculado como ´ | e[k] = SP[k] − P V [k], onde
SP e o ´ | SetPoint e P V e a Vari ´ | avel de Processo (velocidade ´
medida).

B. Arquitetura de Firmware e Otimizaçaõ
O algoritmo de controle e executado em uma ´ | Task dedi-
cada do FreeRTOS com alta prioridade, garantindo determin-
ismo temporal (tempo de execuçao previsto). O per ˜ | íodo de
amostragem (Ts) e fixado em 50ms ( ´ | | 20Hz), suficiente para a
dinamica lenta do ve ˆ | ículo aquatico. ´
Graças a arquitetura Xtensa® 32-bit LX6 do ESP32, que ` possui uma Unidade de Ponto Flutuante (FPU) de hardware,
todos os calculos do PID s ´ | ao realizados utilizando vari ˜ | aveis ´
do tipo float sem penalidade significativa de desempenho,
garantindo precisao na acumulaç ˜ | ao do termo integral e evi- ˜
tando erros de arredondamento comuns em aritmetica de ´ inteiros.
C. Tratamento de Saturaçao e Anti-Windup ˜
Como o atuador (Driver ESC) possui limites físicos de entrada (PWM de 0% a 100%), a saída do PID deve ser limitada (Clamping):

usat[k] =

umax | se u[k] > umax
umin | se u[k] < umin
u[k] | caso contrario ´

(5)

Para evitar o fenomeno de ˆ | Integral Windup — em que
o termo integral cresce indefinidamente enquanto o atuador
esta saturado, causando sobressinal excessivo na recuperaç ´ | aõ
—, implementa-se uma logica de travamento condicional: a ´ integraçaõ I[k] e interrompida sempre que o atuador estiver ´ saturado (u[k] ̸= usat[k]) e o erro tiver o mesmo sinal da saturaçao. ˜
D. Sinal de Controle e Atuaçaõ
O sinal de controle resultante usat[k] e mapeado para o ´
ciclo de trabalho (Duty Cycle) do periferico MCPWM ( ´ | Motor
Control PWM), que gera os pulsos de controle para os ESCs com resoluçao de microssegundos, garantindo uma resposta ˜ suave e linear dos propulsores.
E. Algoritmo de Controle Embarcado
A implementaçao do controlador utiliza o sistema op- ˜ eracional de tempo real (FreeRTOS) presente no ESP32. A logica ´ e encapsulada em uma tarefa de alta prioridade ´ (task_pid_loop) que executa a uma frequencia fixa de ˆ 20Hz.
Abaixo, apresenta-se um exemplo de trecho de codigo ´
essencial que traduz a equaçao matem ˜ | atica (4) para a lin- ´
guagem C++, incluindo as proteçoes de saturaç ˜ | ao e ˜ | anti-
windup.
1 | // Estrutura para armazenar estado do PID
2 | struct PID_State {
3 | float Kp, Ki, Kd;
4 | float prev_error;
5 | float integral;
6 | float output_max;
7 | float output_min;
8 | };

9
10 | // F u n | o de C l c u l o do PID (Executada a cada
ciclo)

11 float pid_compute(PID_State &pid, float setpoint, float measured, float dt) {
12 | // 1. Calcular o erro atual
13 | float error = setpoint - measured;

14
15 | // 2. Termo Proporcional
16 | float P = pid.Kp * error;

17
18 | // 3. Termo Integral (com trava condicional Anti
-Windup)
19 | // S | integra se o sistema n o estiver
saturado
20 | pid.integral += pid.Ki * error * dt;

21
22 | // Clamp da Integral para evitar Windup
excessivo
23 | if (pid.integral > pid.output_max) pid.integral
= pid.output_max;
24 | if (pid.integral < pid.output_min) pid.integral
= pid.output_min;

25
26 | // 4. Termo Derivativo
27 | float D = pid.Kd * (error - pid.prev_error) / dt
;

28
29 | // Atualiza erro anterior para o proximo ciclo
30 | pid.prev_error = error;

31
32 | // 5. Soma e S a t u r a | o Final (Clamping)
33 | float output = P + pid.integral + D;

34
35 | if (output > pid.output_max) output = pid.
output_max;
36 | if (output < pid.output_min) output = pid.
output_min;

37
38 | return output;
39 | }

40
41 | // Task do FreeRTOS (Loop de Controle)
42 | void task_pid_loop(void *pvParameters) {
43 | const TickType_t xFrequency = pdMS_TO_TICKS(50);
// 50ms = 20Hz
44 | TickType_t xLastWakeTime = xTaskGetTickCount();

45
46 | while (1) {
47 | // 1. Leitura dos Sensores (Feedback)
48 | float velocity_now =
get_speed_from_gps_or_esc();

49
50 | // 2. Leitura do Setpoint (vindo da IA/
Navegacao)
51 | float target_speed = get_target_speed_ipc();

52
53 | // 3. Calculo do PID
54 | float pwm_output = pid_compute(motor_pid,
target_speed, velocity_now, 0.05);

55
56 | // 4. Atuacao (MCPWM Hardware)
57 | set_motor_pwm(pwm_output);

58
59 | // Garante determinismo temporal (Bloqueia
ate completar 50ms)
60 | vTaskDelayUntil(&xLastWakeTime, xFrequency);
61 | }
62 | }
Listing 1: Implementaçao da Rotina PID no ESP32 ˜
F. Cenarios de Operaç ´ | ao e Resposta Din ˜ | amica ˆ

Para validar a robustez do algoritmo proposto, ilustram-se
abaixo os dois cenarios mais cr ´ | | íticos de operaçao. ˜

1) Cenario 1: Aceleraç ´ | ao Inicial (Resposta ao Degrau): ˜
Ao receber um comando de partida (SetP oint altera de 0 para 1.5m/s), o controlador deve elevar a potencia dos motores ˆ
rapidamente sem causar oscilaçoes excessivas ( ˜ | Overshoot). A
Figura 11 demonstra o comportamento esperado do sinal de controle (PWM) e da velocidade do ASV.

Tempo (t)

Velocidade (m/s)

Setpoint (1.5m/s)

Velocidade Real (P V )

Overshoot

1s | 2s | 3s | 4s | 5s
Fig. 11: Resposta teorica do PID a um comando de aceleraç ´ | aõ
(Degrau).
2) Cenario 2: Rejeiç ´ | ao de Dist ˜ | urbio (Correnteza/Vento): ´
Durante a navegaçao em cruzeiro, uma rajada de vento ou ˜ correnteza contraria pode frear o ASV subitamente. O termo ´ Integral (I) do PID detecta o erro acumulado e aumenta o PWM automaticamente para compensar a força externa, como ilustrado na Figura 12.

Tempo (t)

Amplitude

Velocidade Alvo

Impacto Onda/Vento

Velocidade
Potencia (PWM) ˆ

Fig. 12: Comportamento do sistema sob perturbaçao externa. ˜ Note o aumento do PWM (verde) para recuperar a velocidade (azul).

VII. CONTROLE DOS ATUADORES (MOTORES E MCPWM)
O subsistema de propulsao realiza a convers ˜ | ao de energia ˜
eletrica em energia cin ´ | etica atrav ´ | es de motores Brushless ´
DC (BLDC). Estes sao controlados de forma independente, ˜
permitindo a navegaçao diferencial do catamar ˜ | | a e eliminando ˜
a necessidade de um leme físico.
A. Dinamica de Propuls ˆ | ao Diferencial (Catamar ˜ | a)˜
O catamara utiliza propuls ˜ | ao diferencial em substituiç ˜ | ao ao ˜
leme convencional. A modelagem do sistema e dividida em ´ dois domínios complementares:
- Cinematica Direta: ´ | Define como as forças resultam em
movimento, considerando a inercia e a massa do ve ´ | ículo.
Esta modelagem e a base para a previs ´ | ao da resposta do ˜
ASV:

vlinear =

Tboreste + Tbombordo
m

(6)

ωangular =

L · (Tboreste − Tbombordo)
Iz

(7)

Onde T representa o empuxo gerado, m a massa total e Iz o momento de inercia. ´
- Cinematica Inversa: ´ | Equaçao executada em tempo real ˜
pelo ESP32 para transformar o vetor de navegaçao (ve- ˜ locidade v e giro ω) em comandos individuais para cada motor:
VR = v +
ω · L
2
(8)

VL = v −

ω · L
2
(9)
Onde L e a dist ´ | ancia entre os centros dos cascos ( ˆ | track
width).
1) Interpretaçao Pr ˜ | atica e Mapeamento: ´ | A logica de con- ´
trole permite tres estados fundamentais: ˆ
- Linha Reta: Com ω = 0, ambos os motores operam em
velocidades identicas ( ˆ | | VR = VL = v).
- Giro sobre o Eixo: Com v = 0, os motores operam com intensidades iguais e sentidos opostos (VR = −VL).
- Curva em Movimento: Com v > 0 e ω > 0, o motor de
Boreste (VR) acelera em relaçao ao de Bombordo ( ˜ | VL),
por exemplo.
Apos o c ´ | alculo de ´ | VL e VR, o sistema realiza o mapeamento
(map) destes valores para o ciclo de trabalho (Duty Cycle)
do periferico MCPWM. Uma velocidade de ´ | | | 1.5 m/s, por
exemplo, e convertida em um sinal PWM correspondente a ´ 75% da potencia do ESC. ˆ
B. Modelo do Motor Brushless (BLDC)
O motor BLDC e modelado como um sistema de segunda ´
ordem. A determinaçao das constantes el ˜ | etricas e mec ´ | anicas ˆ
e vital para o ajuste dos par ´ | ametros do PID ( ˆ | Kp, Ki
| | | , Kd),
prevenindo oscilaçoes: ˜
G(s) = | K
(Ls + R)(Js + b) + K²
| | | (10)
Onde R e L sao a resist ˜ | encia e indut ˆ | ancia das fases, e ˆ | J a
inercia do conjunto rotor-h ´ | elice. ´
C. Funcionamento do ESC (Electronic Speed Controller)
Devido a aus ` | encia de escovas f ˆ | ísicas para a comutaçao de ˜
fases nos motores BLDC, o sistema utiliza ESCs que atuam como inversores trifasicos inteligentes: ´
- Conversao de Sinal: ˜ | O dispositivo interpreta o sinal
PWM (Pulse Width Modulation) de 3.3V originado no ESP32.
- Comutaçao Eletr ˜ | onica: ˆ | Atraves de uma ponte de MOS- ´
FETs, o ESC alterna a corrente entre as tres fases do ˆ motor (A, B e C), gerando o campo magnetico rotativo ´ necessario para o movimento do rotor. ´
- Alimentaçao: ˜ Os controladores sao alimentados direta- ˜ mente por uma bateria Li-Po 4S (14.8V), garantindo o suprimento para as correntes de pico exigidas em aceleraçoes. ˜
D. Criterios de Seleç ´ | ao e Especificaç ˜ | oes ˜
Para garantir a eficiencia e manobrabilidade do ASV, ˆ os ESCs selecionados atendem rigorosamente aos seguintes parametros: ˆ
- Amperagem: Dimensionados para suportar de 30A a 40A, garantindo uma margem de segurança superior a
20% em relaçaõ a corrente m ` | axima nominal dos motores. ´
- Firmware Bidirecional: O projeto utiliza ESCs com firmware SimonK ou BLHeli configurados em modo Bidirectional (Forward/Reverse). Esta abordagem permite
que o robo realize giros sobre o pr ˆ | oprio eixo atrav ´ | es da ´
inversao de rotaç ˜ | ao de um dos motores. ˜
- Compatibilidade Li-Po: Suporte nativo a tens ` | ao de ˜
14.8V (4S).
- BEC Interno: O sistema utiliza o Battery Eliminator Circuit (BEC) integrado para regular a tensao da bateria para ˜
5V, atuando como fonte de alimentaçao de redund ˜ | ancia ˆ
para os sensores.
E. Calculos e Sinais de Controle ´
O controle dos ESCs estabelece-se atraves do protocolo ´
padrao de servomotores, operando em uma frequ ˜ | encia de ˆ
50 Hz (período de 20 ms). A largura de pulso (Pulse Width) define o estado de operaçao: ˜

ms

V

1,5 ms (Neutro)

Duty Cycle ≈ 7,5%

Período Total (20ms / 50Hz)
Fig. 13: Representaçao temporal do sinal PWM enviado aos ˜ ESCs.
- 1.0 ms (1000 µs): Motor parado ou re m´ axima (modo ´ bidirecional).
- 1.5 ms (1500 µs): Ponto neutro (parado no modo bidirecional).
- 2.0 ms (2000 µs): Potencia m ˆ | axima ´ | a frente. `
Para o calculo do valor a ser carregado no perif ´ | erico ´
MCPWM do ESP32 com resoluçao de 16 bits ( ˜ | 2

16 = 65535),
aplica-se a seguinte equaçao: ˜

V alor PWM =

T empo P ulso Desejado
P eriodo T otal

× Resolucao
(11)
Para o estado neutro (1.5 ms):

V alor =

1.5ms
20ms
× 65535 ≈ 4915 | (12)
F. Implementaçao de C ˜ | odigo (MCPWM do ESP32) ´
O controle e executado via perif ´ | erico MCPWM, garantindo ´
precisao superior ao PWM convencional. ˜

1 #include "driver/mcpwm.h"

2
3 | void configurar_motores() {
4 | // Inicializa o MCPWM para os dois motores
5 | mcpwm_gpio_init(MCPWM_UNIT_0, MCPWM0A, 18); //
ESC 1
6 | mcpwm_gpio_init(MCPWM_UNIT_0, MCPWM0B, 19); //
ESC 2

7
8 | mcpwm_config_t pwm_config;
9 | pwm_config.frequency = 50; | // 50Hz para ESCs
10 | pwm_config.cmpr_a = 0; | // 0% duty cycle
inicial
11 | pwm_config.cmpr_b = 0;
12 | pwm_config.counter_mode = MCPWM_UP_COUNTER;
13 | pwm_config.duty_mode = MCPWM_DUTY_MODE_0;
14 | mcpwm_init(MCPWM_UNIT_0, MCPWM_TIMER_0, &
pwm_config);

15 }

16
17 void set_motor_speed(mcpwm_unit_t unit, mcpwm_generator_t gen, float speed) {
18 | // Mapeia -100..100 para 1ms..2ms (5% a 10% de
duty cycle)
19 | float duty = 7.5 + (speed / 100.0) * 2.5;
20 | mcpwm_set_duty(unit, MCPWM_TIMER_0, gen, duty);
21 | }
Listing 2: Configuraçao e Controle de Velocidade via ˜ MCPWM
G. Segurança e Ruído Eletromagnetico (EMI) ´
Para mitigar a interferencia gerada pela r ˆ | apida comutaç ´ | aõ
de corrente nos ESCs, as seguintes medidas sao obrigat ˜ | orias ´
no projeto:
- Capacitores | de | Filtro: Inclusao de capacitores ˜
eletrolíticos na entrada de alimentaçao para estabilizaç ˜ | aõ
da tensao. ˜
- Trançamento de Cabos: Os cabos das fases (A, B e C) entre ESC e motor sao trançados para cancelamento de ˜ campo eletromagnetico. ´
- Isolamento de Sinais: As linhas de comunicaçao UART ˜ sao posicionadas fisicamente afastadas dos cabos de ˜
potencia para prevenir corrupç ˆ | ao de dados. ˜

VIII. SUBSISTEMA DE SINALIZAÇ AÕ NAUTICA ´
(RIPEAM)
A operaçao de Ve ˜ | ículos de Superfície Autonomos (ASV) ˆ
em corpos d’agua compartilhados exige estrita conformidade ´ com o RIPEAM (Regulamento Internacional para Evitar Abalroamentos no Mar). Para esta embarcaçao, classificada ˜
como de pequeno porte (< 7 metros) e propulsao mec ˜ | anica, o ˆ
sistema de sinalizaçao visual n ˜ | aõ e apenas um acess ´ | orio, mas ´
um requisito mandatorio de segurança para evitar colis ´ | oes e ˜
indicar o status operacional do robo a outras embarcaç ˆ | oes. ˜
A. Logica de Sinalizaç ´ | ao e Estados ˜
O controle das luzes de navegaçaõ e gerenciado pelo ESP32 ´ (Controlador), que opera com base em duas variaveis de ´

decisao: ˜ | Luminosidade Ambiental (detectada via sensor LDR
ou relogio astron ´ | omico via GPS) e ˆ | Estado da Missaõ (vindo
da FSM).
A logica de controle implementada segue a tabela de ´ verdade normativa simplificada:

TABLE III: Matriz de Controle de Iluminaçao (Conformidade ˜ RIPEAM)

Condiçao Ambiental ˜ | Estado | Configuraçao de Luzes ˜
Dia (> 500 Lux) | Qualquer | Desligado (Economia)
Noite (< 100 Lux) | Em Movimento | Bordo (Enc/Ver) + Mastro (Branca)
Noite (< 100 Lux) | Parado | Alcançado (Branca 360◦)
Qualquer | Falha | Estrobo (Perigo)

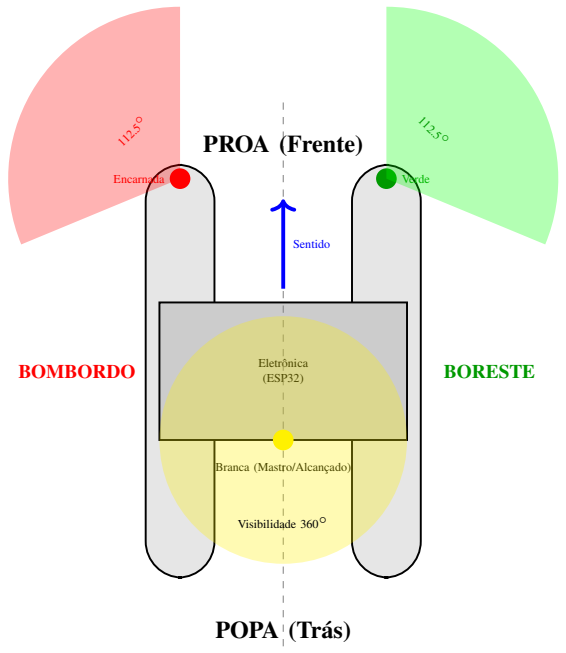
[picture p25: figure]
Eletronica ˆ (ESP32); Encarnada; Verde; Branca (Mastro/Alcançado); Visibilidade 360◦; PROA (Frente); POPA; (Tras) ´; BOMBORDO; BORESTE; Sentido

Fig. 14: Layout ”Top-Down” do Catamara: Posicionamento ˜ dos LEDs conforme RIPEAM.

B. Interface de Potencia e Hardware ˆ
As luzes de navegaçao LED de alta luminosidade operam ˜ tipicamente com correntes na ordem de 300mA a 1A, alimentadas diretamente pela bateria de 12V (ou 14.8V).
Conforme especificado no datasheet do controlador, os pinos de I/O (GPIO) do ESP32 possuem capacidade de corrente de fonte (source current) limitada a 40mA. Esta corrente
e insuficiente para acionar diretamente os LEDs de pot ´ | encia. ˆ
Alem disso, a tens ´ | ao de operaç ˜ | ao dos LEDs (12V) excede a ˜
tensao m ˜ | axima absoluta dos pinos do ESP32 (3.6V), o que ´
causaria dano irreversível ao microcontrolador em caso de conexao direta. ˜
Para solucionar essa incompatibilidade de tensao e corrente, ˜ projetou-se um estagio de acionamento utilizando MOSFETs ´ de Canal N em configuraçaõ Low-Side Switch. O ESP32 envia
um sinal logico de 3.3V para o ´ | | Gate do MOSFET, que entaõ

fecha o circuito de terra dos LEDs de 12V, permitindo o
acionamento de alta potencia com total isolamento da l ˆ | ogica ´
de controle.

### V BAT (+14.8V)

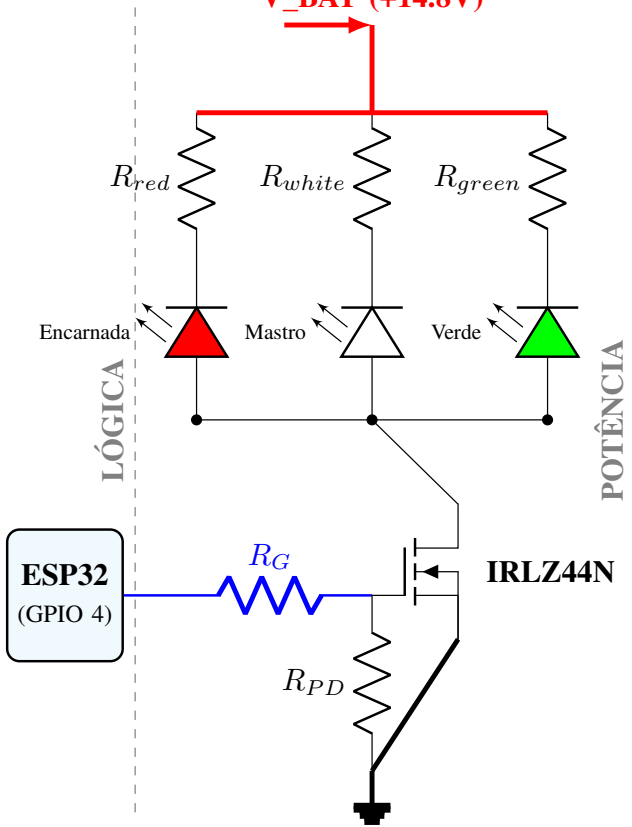
[picture p26: figure]
ESP32; (GPIO 4); RPD; IRLZ44N; Encarnada; Rred; Mastro; Rwhite; Verde; Rgreen; L ÓGICA; POT ÊNCIA

Fig. 15: Topologia de acionamento com separaçao clara entre ˜
estagio de pot ´ | encia e controle. ˆ
C. Justificativa de Segurança
A implementaçao deste sistema garante que, em caso de ˜ falha do software principal (”travamento”), o resistor de pull-down (Figura 15) garante que as luzes nao fiquem piscando ˜ aleatoriamente, mantendo o estado conhecido. Adicionalmente, o uso do MOSFET permite aplicar PWM (Modulaçaõ por Largura de Pulso) caso seja necessario ajustar a inten- ´ sidade luminosa para economizar bateria em situaçoes de ˜
emergencia, estendendo a autonomia de sinalizaç ˆ | ao visual. ˜
| IX. INTERFACES DE COMUNICAÇ AÕ
A. UART (Interprocessador)
A integraçao entre o subsistema de processamento de ˜ alto nível (ESP32-S3 - Cerebro) e o subsistema contro- ´ lador (ESP32-WROOM-32) e estabelecida via interface UART ´ (Universal Asynchronous Receiver-Transmitter). Esta escolha fundamenta-se na natureza ponto-a-ponto da comunicaçao, ˜ garantindo um canal de dados exclusivo e direto entre os dois processadores, o que elimina conflitos de barramento e simplifica a arquitetura de rede do ASV.

O sistema utiliza o hardware dedicado (U2 UART) do ESP32 nos pinos GPIO 16 (RX2) e 17 (TX2). Esta
configuraçao permite que perif ˜ | ericos internos gerenciem a ´
transmissao de bits de forma independente, poupando ciclos ˜ de processamento da CPU principal.
1) Protocolo e Gramatica de Dados (Topologia de Frame): ´ A interface UART opera em full-duplex, permitindo que comandos de navegaçao desçam para o controlador enquanto ˜ a telemetria de sensores (velocidade, status da bateria e di-
agnostico) sobe para o c ´ | erebro simultaneamente. Para garantir ´
a troca de informaçoes sem ambiguidades, o sistema utiliza ˜ uma topologia de frame padronizada.
A estrutura do frame mitiga os efeitos de interferencia ˆ
eletromagnetica (EMI) provenientes da comutaç ´ | ao dos mo- ˜
tores Brushless atraves dos seguintes elementos: ´

Header
(0xAA)

Payload
(v_linear + w_angular)

Checksum
(Sum 8-bit)

Frame Completo (10 Bytes)
Fig. 16: Topologia do frame de comunicaçao UART entre ˜ Cerebro e Controlador. ´
- Header (0xAA): Sinal de atençao em hexadecimal ˜
(binario 10101010). Este padr ´ | ao de onda quadrada as- ˜
segura a sincronizaçao inicial do receptor, validando o ˜ início da mensagem e descartando ruídos residuais.
- Payload (Carga Util): ´ | Conteudo real do ´ | frame, contendo
os valores de SetPoint para o controle PID e comandos de acionamento de luzes.
- Checksum (Soma de Verificaçao): ˜ Selo de segurança calculado sobre o Payload. O controlador descarta qualquer mensagem cujo valor recebido divirja do calculado,
prevenindo execuçoes err ˜ | aticas causadas por interfer ´ | encia ˆ
eletrica. ´
O firmware utiliza o Checksum de Soma de 8 bits (Modulo ´
256), garantindo alta eficiencia nos n ˆ | ucleos de 32 bits e ´
validaçao em microssegundos, mantendo o determinismo tem- ˜ poral do FreeRTOS. Matematicamente, a operaçaõ e definida ´ pela Equaçao (13): ˜

Checksum =

Xn

i=1

Bytei

!
(mod 256) | (13)
Onde n e o total de bytes no ´ | Payload e Bytei representa
cada valor individual. O operador modulo garante o trunca- ´ mento para exatamente 1 byte.
1 | // F u n | o de C l c u l o de Checksum (M d u l o 256)
2 | uint8_t calcular_checksum(uint8_t* payload, size_t
tamanho) {
3 | uint32_t soma = 0;
4 | for (size_t i = 0; i < tamanho; i++) {
5 | | soma += payload[i];
6 | }
7 | return (uint8_t)(soma & 0xFF);
8 | }

9

10 | // V a l i d a | o na r e c e p | o do comando
11 | void validar_comando(uint8_t* frame_recebido) {
12 | uint8_t checksum_recebido = frame_recebido[
tamanho_total - 1];
13 | uint8_t checksum_calculado = calcular_checksum(
frame_recebido, tamanho_payload);

14
15 | if (checksum_calculado == checksum_recebido) {
16 | // Checksum v l i d o: comando enviado ao PID
17 | processar_motores();
18 | } else {
19 | // Erro detectado: descarte por EMI
20 | log_erro_comunicacao();
21 | }
22 | }
Listing 3: Implementaçao da Validaç ˜ | ao de Checksum UART ˜
2) Síntese da Relaçao de Controle e Comunicaç ˜ | ao: ˜ | A
integridade da mensagem via UART e a premissa para a aç ´ | aõ
física do veículo. Conforme o diagrama de conexao (Fig. 17), ˜
| a traduçao do dado l ˜ | ogico em pot ´ | encia ocorre sob os seguintes ˆ
pilares:

ESP32
3.3V Logica ´

Driver ESC
(Controle de Potencia) ˆ | M

Brushless

Li-Po 4S

+ −

14.8V

+ | −

VCC
GND

PWM (GPIO)

GND Comum

Fase A

Fase B

Fase C

Fig. 17: Interface de Potencia e Controle: Integraç ˆ | ao entre ˜
| sinais logicos e acionamento trif ´ | asico. ´
- Papel dos ESCs: O Electronic Speed Controller atua
como estagio de pot ´ | encia, convertendo o sinal PWM ˆ
(baseado no Payload da UART) em pulsos trifasicos de ´ alta corrente para os motores, utilizando a energia da bateria Li-Po 4S.
| • Referencia de GND Comum: ˆ | A conexao de GND Co- ˜
mum entre o ESP32 e a bateria e vital para a interpretaç ´ | aõ
correta da mensagem logica. Esta refer ´ | encia unificada ˆ
impede a flutuaçao do sinal de controle e garante a ˜ estabilidade de rotaçao. ˜
3) Implementaçao da Interpretaç ˜ | ao UART: ˜ | O firmware
do controlador executa uma rotina de recepçao robusta para ˜ garantir que apenas mensagens legítimas sejam processadas.
1 | struct ComandoNav {
2 | uint8_t header; | // Deve ser 0xAA
3 | float v_linear; | // 4 bytes
4 | float w_angular; | // 4 bytes
5 | uint8_t checksum; | // Soma de v e r i f i c a | o
6 | };

7
8 | void processar_comunicacao_uart() {
9 | if (Serial2.available() >= sizeof(ComandoNav)) {
10 | if (Serial2.peek() == 0xAA) {
11 | ComandoNav comando;

12 | Serial2.readBytes((uint8_t*)&comando,
sizeof(ComandoNav));

13
14 | uint8_t* payload = (uint8_t*)&comando.
v_linear;
15 | uint8_t calc_checksum =
calcular_checksum(payload, 8);

16
17 | if (calc_checksum == comando.checksum) {
18 | ultima_comunicacao =
xTaskGetTickCount();

19
20 | float L = 0.4; // 40cm entre cascos
21 | float vel_boreste = comando.v_linear
+ (comando.w_angular * L / 2.0);
22 | float vel_bombordo = comando.
v_linear - (comando.w_angular * L / 2.0);

23
24 | aplicar_soft_start_boreste(
vel_boreste);
25 | aplicar_soft_start_bombordo(
vel_bombordo);
26 | } else {
27 | log_erro("Checksum Invalido - Ruido
EMI detectado");
28 | }
29 | } else {
30 | Serial2.read(); // Procura proximo
header
31 | }
32 | }
33 | }
Listing 4: Algoritmo de Interpretaçao UART e Cinem ˜ | atica ´
Inversa
4) Implementaçao de Partida em Rampa (Soft-Start): ˜ | | Para
proteger a integridade estrutural e evitar picos de corrente que resultariam em resets do microcontrolador, o sistema utiliza uma aceleraçao gradual. ˜
1 | float pwm_atual = 0.0;
2 | const float TAXA_ACELERACAO = 2.0; // Incremento de
2% por ciclo

3
4 | void aplicar_soft_start(float pwm_alvo) {
5 | if (pwm_atual < pwm_alvo) {
6 | pwm_atual += TAXA_ACELERACAO;
7 | if (pwm_atual > pwm_alvo) pwm_atual =
pwm_alvo;
8 | } else if (pwm_atual > pwm_alvo) {
9 | pwm_atual -= TAXA_ACELERACAO;
10 | }
11 | set_motor_pwm(pwm_atual);
12 | }
Listing 5: Logica de Soft-Start para Proteçao Mec ˜ | anica ˆ
5) Otimizaçoes de Efici ˜ | encia: ˆ | O projeto adota estrategias ´
para maximizar a autonomia energetica: ´
- Dynamic Frequency Scaling (DFS): Reduçao do clock ˜ do ESP32 para 80 MHz. Esta medida economiza 30% de energia sem comprometer o controle de 20 Hz.
- Hardware PWM (LEDC): Utilizaçao do perif ˜ | erico ´
LEDC para geraçao de pulsos, garantindo estabilidade ˜ de frequencia independente da CPU. ˆ
B. Watchdog de Comunicaçaõ
A segurança operacional do ASV em ambientes aquaticos ´
e uma prioridade cr ´ | ítica, exigindo mecanismos que eliminem

riscos de perda de controle por falhas no processador principal ou desconexao f ˜ ísica. Para este fim, o sistema utiliza um Watchdog de Comunicaçao, que atua como um supervisor de ˜ ”batimento cardíaco” (heartbeat) integrado ao firmware do controlador.
1) Conceito e Diferenciaçao T ˜ | ecnica: ´ | Diferente do Task
Watchdog Timer (TWDT) nativo do ESP32, que monitora
o travamento de loops de codigo internos, o ´ | Watchdog de
Comunicaçao supervisiona a integridade do enlace entre o ˜ Cerebro (ESP32-S3) e o Controlador (ESP32-WROOM-32). ´ O sistema interpreta o recebimento regular de pacotes UART como o pulso vital do sistema; enquanto as mensagens saõ
recebidas, o controlador mantem a operaç ´ | ao ativa, validando ˜
que o comando superior esta operante. ´
2) Logica Matem ´ | atica e Temporal: ´ | A logica do ´ | Watchdog é
de natureza temporal e condicional. A condiçao de segurança ˜ baseia-se no monitoramento do tempo decorrido desde o
ultimo pacote v ´ | alido recebido ( ´ | Tultimo pacote). O estado de
operaçao normal ˜ | e mantido estritamente enquanto: ´
Tatual − Tultimo pacote < Ttimeout | (14)
O limite de tempo (Ttimeout) e fixado em ´ | | 500 ms. Este
valor e definido como exatamente dez vezes o per ´ | | íodo de
amostragem do PID (Ts = 50 ms), estabelecendo uma margem de segurança que elimina falsos positivos. Esta configuraçaõ evita que o sistema entre em estado de falha por pequenos atrasos (jitter) no processamento da IA ou na latencia de ˆ
transmissao, garantindo a estabilidade da navegaç ˜ | ao. ˜
3) Implementaçao e Failsafe (L ˜ | ogica de Segurança): ´ | A
implementaçaõ e realizada via software, utilizando as capaci- ´ dades multitarefa do FreeRTOS, o que dispensa componentes de hardware adicionais. O algoritmo executa uma logica de ´ Failsafe rigorosa:

Início Loop

Tempo > 500ms? | FAILSAFE (STOP)

Aguardar 100ms

Sim

Naõ

Fig. 18: Logica de decis ´ | ao do Watchdog de comunicaç ˜ | ao. ˜
- Reinicializaçao: ˜ | A cada frame UART validado pelo
Checksum, o sistema zera o temporizador de segurança.
- Estado de Emergencia: ˆ | Caso a ausencia de comunicaç ˆ | aõ
exceda os 500 ms, o controlador identifica o travamento
ou desconexao do sistema de alto n ˜ | ível.
- Açoes Imediatas: ˜ | O subsistema interrompe instantanea-
mente o sinal PWM enviado aos ESCs (PWM = 0), ces-
sando a propulsao para evitar colis ˜ | oes. Simultaneamente, ˜
o estado de missaõ e alterado para ”Falha”, acionando ´ o Estrobo Vermelho (Perigo) conforme a conformidade RIPEAM detalhada na Tabela III.

Abaixo, apresenta-se a implementaçao da tarefa de super- ˜ visao: ˜

1 | // Limite de seguranca definido para 500ms
2 | const TickType_t WATCHDOG_TIMEOUT = pdMS_TO_TICKS
| (500);
3 | TickType_t ultima_comunicacao = 0;

4
5 | // Tarefa dedicada para monitoramento do Heartbeat
6 | void task_watchdog_comunicacao(void *pvParameters) {
7 | while(1) {
8 | // Verifica tempo decorrido desde o ultimo
| pulso
9 | if ((xTaskGetTickCount() -
ultima_comunicacao) > WATCHDOG_TIMEOUT) {
10 | // ENTRADA EM ESTADO DE SEGURANCA (
| FAILSAFE)
11 | set_motor_pwm(0); | //
| Interrompe propulsao
12 | acionar_sinalizacao_falha(); | //
| Estrobo Vermelho RIPEAM
13 | }
14 | vTaskDelay(pdMS_TO_TICKS(100)); | //
| Monitoramento a cada 100ms
15 | }
16 | }

17
18 | // Funcao executada na validacao de cada pacote UART
19 | void on_valid_packet_received() {
20 | ultima_comunicacao = xTaskGetTickCount(); //
| Reinicia o Watchdog
21 | }
Listing 6: Tarefa de Supervisao Heartbeat no FreeRTOS ˜

REFERENCES

[1] Kostiantyn Oliynyk, ”ESP32 Development Platforms: A Comprehensive Analysis and Comparison” (2025)
[2] Espressif, ”ESP32-WROOM-32 Datasheet Version 3.6” (2025)
[3] Norman S. Nise , ”Engenharia de Sistemas de Controle 6° Ediçao” ˜ (2012)
[4] Hernani B. da Cruz , Sani de C. R. da Silva e Silvio L. R. da Silva , ”Guia de Programaçao ESP32” (2022) ˜
[5] L. Makridis et al., “Reliable Communication Protocols for Autonomous Underwater and Surface Vehicles,” OpenAlex, 2023.
[6] J. Blos, Controle de motor brushless CC embarcado com partida em
rampa, TCC (Engenharia Eletrica), USP S ´ | ao Carlos, 2018. ˜
[7] G. C. Santos et al., “Modelagem Matematica e Simulaç ´ | ao do Motor ˜
Brushless,” Salao do Conhecimento UNIJU ˜

Í, 2022.
[8] Revista Mundi, “Modelagem Matematica de um Ve ´ | ículo de Superfície:
Dinamica e Hidrodin ˆ | amica de um Catamar ˆ | a,” ˜ | Engenharia, Tecnologia
e Gestaõ , vol. 8, 2023.
