AlphaCompLabs/H-Drop/Docs/Subsistema_de_Alimentação_TCC (1).pdf

# Subsistema de Alimentaçaõ

1

° Diogo Freitas Machado
Engenharia de Computaçaõ
Instituto de Educaçao Superior de Bras ˜ | ília - IESB
Brasília, DF
diogo.machado@iesb.edu.br
2312082012

2

° Elisa Nunes de Freitas
Engenharia de Computaçaõ
Instituto de Educaçao Superior de Bras ˜ | ília - IESB
Brasília, DF
elisa.freitas@iesb.edu.br
2312082040
Orientador: Paulo Henrique Moreira de Carvalho Faria
Engenharia Eletronica & Engenharia de Software ˆ
Instituto de Educaçao Superior de Bras ˜ | ília - IESB
Brasília, DF
paulo.faria@iesb.edu.br
201836
Abstract—Este documento e uma formalizaç ´ | ao das pesquisas ˜
realizadas sobre tudo o que tange a respeito de alimentaçao para ˜ o ASV a ser desenvolvido.
Index | Terms—energia, | alimentaçao, | foto- ˜
voltaica,bateria,carregamento
I. INTRODUÇ AO E ˜ | DEFINIÇ AO DO ˜ | ESCOPO

Para o desenvolvimento de um Sistema Integrado para a
Detecçao Inteligente de Poluentes como Subs ˜ | ídio para Gestaõ
e Uso de Corpos Hídricos foi definido que as pesquisas
teoricas devem ser iniciadas pelo coraç ´ | | ao do projeto que ˜
permitira o funcionamento de todos os outros componentes ´
eletricos/eletr ´ | onicos. Dessa forma, pertence ao escopo desta ˆ
documentaçao todos os resultados das pesquisas te ˜ | oricas re- ´
alizadas por Diogo Freitas Machado sobre o que refere-se à alimentaçao do sistema final planejado. ˜
II. FUNDAMENTAÇ AÕ TEORICA ´ | (FÍSICA & MATEMATICA ´ | )
Esta seçao estabelece o rigor cient ˜ | ífico que norteia as
decisoes de engenharia do projeto. A an ˜ | | alise abrange desde ´
a física do estado solido at ´ | e a din ´ | amica de fluidos, criando ˆ
um modelo integrado para a eficiencia energ ˆ | etica. ´
A. Física do Estado Solido e Dissipaç ´ | ao Digital (Mi- ˜
croeletronica) ˆ
Antes de detalhar as equaçoes, contextualiza-se a arquitetura ˜ definida. Para o sistema embarcado, adotou-se uma Topologia
Dual-Core Heterogenea (ESP32-S3 como ”C ˆ | erebro” + ESP32 ´
Standard como ”Controlador”). Para o sistema de potencia, ˆ definiu-se:
- Fonte: Híbrida (Placa Solar 60W + Bateria Li-PO 4S).
- Topologia de Controle: Controlador MPPT na entrada e Conversores Buck (Step-down) na distribuiçao. ˜
- Inteligencia: ˆ | Algoritmo de Gestao Din ˜ | amica de Energia ˆ
(DPM) executado no ESP32-S3.
A justificativa para o uso de reguladores chaveados (Buck) em detrimento de lineares (LDO) baseia-se na minimizaçaõ
da dissipaçao t ˜ | ermica. Enquanto um regulador linear dissipa o ´
excedente de tensao como calor ˜ | (Pdiss = (Vin − Vout) · I), o
conversor Buck utiliza elementos reativos (indutor e capacitor) para transformar a energia, teoricamente sem perdas resistivas, obedecendo ao princípio da conservaçao de energia onde ˜

VinIin · η = VoutIout.
A analise de consumo do processador segue a equaç ´ | ao de ˜
circuitos CMOS:

Ptotal = Pcomutacao+Pcurto−circuito+Pfuga+Pestatica (1)

- Potencia Din ˆ | amica ( ˆ | Pcomutacao): Componente domi-
nante em operaçao ativa, dada por: ˜

Pdyn = α · CL · V

2
dd · f | (2)
A dependencia quadr ˆ | atica da tens ´ | ao ( ˜ | V

2
| | | dd) justifica o
esforço em operar os nucleos na menor tens ´ | ao est ˜ | avel ´
possível, enquanto o termo linear da frequencia ( ˆ | f) per-
mite que o algoritmo DPM reduza o consumo linearmente ao diminuir o clock em momentos de baixa demanda.
- Potencia de Vazamento ( ˆ | Pfuga): Crítica durante a re-
carga estatica. A corrente sublimiar ´ | | e modelada por: ´

Isub ∝ µCox

W
L
kT
q

2
e

Vgs−Vth
nkT /q | (3)
Analise T ´ | ermica: ´ | A variavel ´ | T (temperatura) no ex-
poente indica que o calor do Lago Paranoa (Estudo de ´ Caso) pode aumentar drasticamente a fuga de corrente. Isso fundamenta a necessidade de Power Gating (corte físico de energia via MOSFETs) para sensores inativos, em vez de apenas suspensao l ˜ ogica. ´
B. Física da Conversao Fotovoltaica e Controle ˜
O sistema opera sob energia limitada. A geraçao solar ˜ | é
estocastica (”Aleat ´ | oria”), dependendo da irradi ´ | ancia, descrita ˆ
pela Equaçao do Diodo Fotovoltaico: ˜
| I = Iph − I0
| | e q(V +IRs)
| | nkT | − 1

| | | − V + IRs
| | | Rsh (4)

A conexao direta painel-bateria causaria descasamento de ˜
impedancia. O algoritmo MPPT ( ˆ | Maximum Power Point
Tracking), essencial ao projeto, busca iterativamente o ponto onde a derivada da potencia ˆ e nula: ´

dP
dV = 0 | (5)
Isso garante que, mesmo com variaçoes t ˜ | ermicas que afetam ´
a tensao de circuito aberto ( ˜ | Voc), o sistema extraia a potencia ˆ
maxima nominal (60W). ´
C. Eletroquímica e Armazenamento

O subsistema de armazenamento atua como o buffer en-
ergetico cr ´ | ítico entre a geraçao estoc ˜ | astica (solar) e a demanda ´
dinamica (propuls ˆ | ao). A seleç ˜ | ao da tecnologia de bateria ˜
para o ASV fundamenta-se na analise de tr ´ | es par ˆ | ametros ˆ
eletroquímicos conflitantes: Densidade de Energia (Autono-
mia/Peso), Potencia Espec ˆ | ífica (Capacidade de Corrente de
Pico) e Estabilidade Química (Segurança e Ciclo de Vida). Abaixo, analisam-se as principais químicas candidatas e seus comportamentos físicos sob carga:
1) Analise de Tecnologias Candidatas: ´
- Chumbo-Acido (VRLA/AGM): ´ | Historicamente comum,
apresenta severas limitaçoes para propuls ˜ | ao el ˜ | etrica dev- ´
ido à Lei de Peukert. Esta lei fenomenologica dita que a ´ capacidade disponível de uma bateria diminui conforme a taxa de descarga aumenta (Cp = I

k
t). Em regimes
de alta corrente exigidos pelos motores Brushless, uma bateria de chumbo perderia grande parte de sua capaci-
dade util, al ´ | em de possuir baixa densidade gravim ´ | etrica ´
(30 − 40W h/kg), penalizando a hidrodinamica. ˆ
- Lítio-Ferro-Fosfato (LiFePO4): Caracteriza-se pela estrutura cristalina de olivina, que confere alta estabilidade
termica e qu ´ | ímica.
– Vantagem Eletroquímica: Possui uma curva de descarga extremamente plana (tensao constante em ˜ 3.2V/celula durante 90% do ciclo) e suporta milhares ´ de ciclos (2000 ou mais) sem degradaçao significa- ˜ tiva.
– Segurança: E intrinsecamente segura contra ´ | ther-
mal runaway (fuga termica), ideal para operaç ´ | oes ˜
autonomas sem supervis ˆ | ao humana. ˜
- Polímero de Lítio (Li-Po): Variante da tecnologia Li-Ion
com eletrolito polim ´ | erico, amplamente usada em rob ´ | otica ´
movel. ´
– Vantagem Eletroquímica: Apresenta a menor re-
sistencia interna ( ˆ | Rint) entre as opçoes, permitindo ˜
taxas de descarga (C-Rating) altíssimas (20C a 50C)
sem queda brusca de tensao ( ˜ | Voltage Sag). Oferece
a maior densidade energetica ( ´ | 150 − 200W h/kg).
– Desvantagem: Maior instabilidade termica e vida ´ | util ´
reduzida (300-500 ciclos).
2) Matriz de Decisao T ˜ | ecnica: ´ | A Tabela I sintetiza as
características para a tomada de decisao do projeto. ˜

TABLE I: Comparativo Tecnico: Tecnologias de Armazena- ´ mento de Energia

Parametro | LiFePO4 | Li-Po | Chumbo- ˆ | Acido ´

Densidade (W h kg⁻¹
) | 90–120 | 150–200 | 30–40
Vida Util (Ciclos) ´ | > 2000 | 300–500 | 500–800
Segurança Termica | Alta | Cr ´ | ítica | Alta
Efeito Peukert | Baixo (k ≈ 1.05) | Baixo | Alto (k ≈ 1.3)

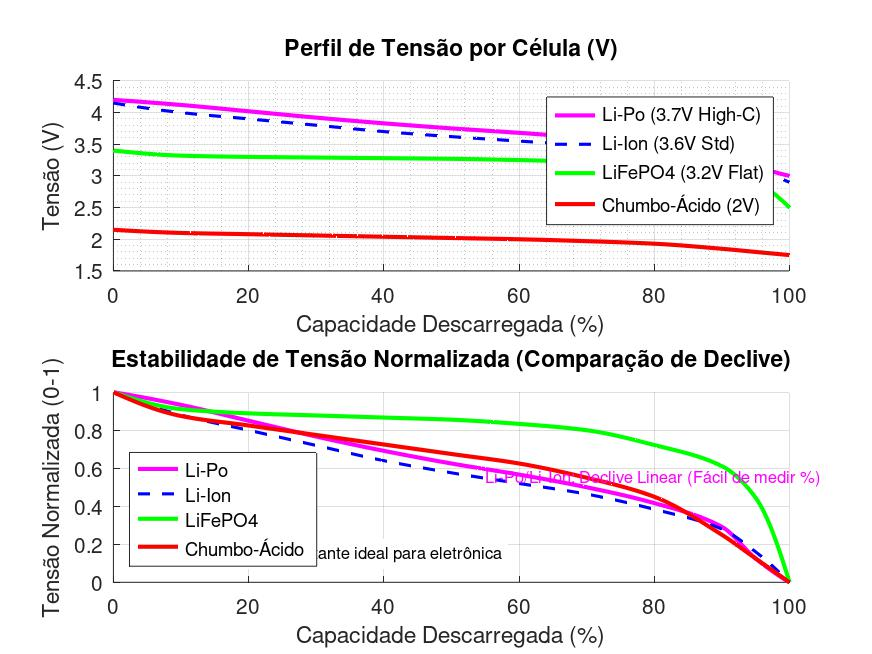
[picture p27: figure]

Fig. 1: Comparaçao LiFePo4, Chumbo- ˜ | Acido e Li-Po ´
3) Estimativa de Estado (SoC): Independentemente da
química escolhida (Li-Po ou LiFePO4), a gestao energ ˜ | etica ´
via IA depende do conhecimento preciso da energia restante.
A simples leitura de tensaõ | e imprecisa para baterias de ´
Lítio devido as curvas de descarga n ` | | ao-lineares ou planas. ˜
Portanto, o metodo matem ´ | atico mandat ´ | orio para o sistema ´ | é
a Contagem de Coulomb (Coulomb Counting):

SoC(t) = SoC(t0) −

1
Cn

Z t

| | t0
Ibat(τ )dτ | (6)
Onde Cn e a capacidade nominal e ´ | Ibat e a corrente ´
instantanea medida pelos sensores (positiva na descarga, neg- ˆ ativa na carga). Este algoritmo sera executado pelo ESP32-S3 ´
para alimentar a funçao de custo de navegaç ˜ | ao. ˜
D. Dinamica de Fluidos e Otimizaç ˆ | aõ
A interaçao do ASV com o meio aqu ˜ | atico ´ | e modelada ´
pelas equaçoes de ˜ | Navier-Stokes, simplificadas para o modelo
vetorial de Fossen:
Mν˙ + C(ν)ν + D(ν)ν + g(η) = τ | (7)
- M (Massa + Massa Adicionada): Inercia do corpo mais ´ a massa de agua deslocada. ´
- C(ν) (Coriolis): Forças centrífugas e de Coriolis devido a rotaç ` ao do referencial. ˜
- D(ν) (Amortecimento): O termo crítico. Em regime de cruzeiro, o arrasto quadratico predomina. ´

- g(η) (Vetor de Forças de Restauraçao) : ˜ Representa as forças gravitacionais e de empuxo que tendem a retornar
o ASV a posiç ` | ao de equil ˜ | íbrio horizontal.
- τ (Vetor de Forças de Atuaçao) : ˜ | A força propulsiva e
o torque gerados pelos motores Brushless.
1) A Funçao de Custo Energ ˜ | etica: ´ | Devido ao termo D(ν),
a potencia de propuls ˆ | ao segue a relaç ˜ | ao c ˜ | ubica ´ | Preq ∝ v

3
. Esta
restriçao f ˜ | ísica e a base da Funç ´ | ao de Custo ( ˜ | J) minimizada
pelo algoritmo do ESP32-S3:

J(v) = w1 ·

| Drest
v

+ w2 · e

λ(Ereserva−Eproj (v)) | (8)

Onde Eproj (v) utiliza a integral de Coulomb e a previsaõ solar para estimar o saldo final. O sistema busca o ponto
otimo onde a velocidade ´ | e suficiente para cumprir a miss ´ | aõ
(Drest/v), mas baixa o suficiente para manter o risco energetico (termo exponencial) sob controle. ´

III. ARQUITETURA DO SISTEMA (HARDWARE)
A materializaçao da fundamentaç ˜ | ao te ˜ | orica apresentada ´
anteriormente concretiza-se em uma arquitetura de hardware
distribuída e heterogenea. O sistema ser ˆ | a projetado visando ´
garantir isolamento de falhas, eficiencia energ ˆ | etica m ´ | axima e ´
capacidade de processamento de IA. A arquitetura divide-se
em tres subsistemas cr ˆ | íticos: Processamento Logico, Est ´ | agio ´
de Potencia e Atuaç ˆ | ao/Sensoriamento. ˜
A. Topologia de Processamento Distribuído (Dual-Core Heterogeneo) ˆ
Para solucionar o problema entre o processamento es-
tocastico de dados (IA/Vis ´ | ao) e o controle determin ˜ | ístico
de hardware, optou-se (inicialmente) por uma arquitetura de duplo processador segregada funcionalmente:
- Unidade de Processamento Cognitivo (O Cerebro): ´

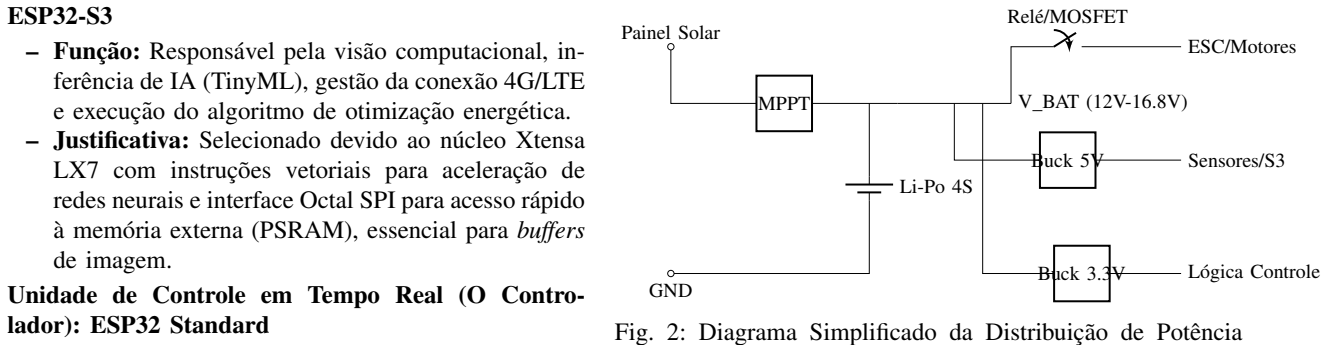
[picture p28: figure]
ESP32-S3; – Funçao: ˜; Responsavel pela vis ´; ao computacional, in- ˜; de imagem.; lador): ESP32 Standard; Painel Solar; MPPT; GND; V BAT (12V-16.8V); Buck 5V; Sensores/S3; Buck 3.3V; Logica Controle ´; Rele/MOSFET ´; ESC/Motores

ferencia de IA (TinyML), gest ˆ | ao da conex ˜ | ao 4G/LTE ˜
e execuçao do algoritmo de otimizaç ˜ | ao energ ˜ | etica. ´
– Justificativa: Selecionado devido ao nucleo Xtensa ´
LX7 com instruçoes vetoriais para aceleraç ˜ | ao de ˜
redes neurais e interface Octal SPI para acesso rapido ´
a mem ` | oria externa (PSRAM), essencial para ´ | buffers
- Unidade de Controle em Tempo Real (O Contro-

– Funçao: ˜ Responsavel exclusivamente pelo aciona- ´ mento dos motores (PWM) e LEDs, leitura de sensores de segurança e monitoramento do Watchdog de hardware.
– Justificativa: Garante o determinismo temporal (Hard Real-Time). Se o cerebro travar processando ´ uma imagem ou reconectando a rede, o controlador
mantem o ASV est ´ | avel ou o para com segurança. ´
- Interconexao (IPC): ˜ | A comunicaçao entre os n ˜ | ucleos ´
ocorre via barramento UART de Alta Velocidade

(921kbps ou mais) utilizando um protocolo binario com ´ verificaçao de integridade (CRC) para tentar evitar a ˜
interferencia dos ru ˆ | ídos eletromagneticos dos motores. ´
B. Subsistema de Potencia e Efici ˆ | encia ˆ
O gerenciamento de energia segue a premissa de ”eficiencia ˆ
em cadeia”, onde cada estagio de convers ´ | ao minimiza perdas ˜
termicas e otimiza a relaç ´ | ao peso-pot ˜ | encia: ˆ
- Geraçao: ˜ | Painel Fotovoltaico Monocristalino de 60W,
selecionado pela alta densidade de potencia por ˆ | area ´
(W/m²
).
- Condicionamento de Entrada (MPPT): Controlador de
Carga com rastreamento do ponto de maxima pot ´ | encia. ˆ
Este estagio desacopla a tens ´ | ao do painel da tens ˜ | ao da ˜
bateria, garantindo a extraçao real dos 60W nominais. ˜
- Armazenamento: Bateria de Polímero de Lítio (Li-Po). Escolhida pela alta densidade gravimetrica (leveza) ´ e capacidade de fornecer altas correntes de descarga (High C-Rating) exigidas pelos motores, superando as
limitaçoes de peso das qu ˜ | ímicas tradicionais.
- Distribuiçao (PDU): ˜ | Utilizaçao estrita de Reguladores ˜
Chaveados (Buck Converters) para reduzir a tensao da ˜ bateria (14.8V nominais) para os níveis logicos (5V/3.3V) ´
com eficiencia superior a 90%, minimizando a dissipaç ˆ | aõ
termica. ´
- Atuaçao (Propuls ˜ | ao): ˜ | Drivers ESC (Electronic Speed
Controllers) bidirecionais conectados diretamente ao bar-
ramento de alta corrente, responsaveis pela comutaç ´ | aõ
trifasica para os motores Brushless. ´
- Segurança (Safety): Inclusao de fus ˜ | ível geral de
proteçao, chave de corte de emerg ˜ | encia (E-Stop) e moni- ˆ
toramento de tensao por c ˜ | elula (BMS) devido ´ | a sensibil- `
idade da química Li-Po.
Fig. 2: Diagrama Simplificado da Distribuiçao de Pot ˜ | encia ˆ
(PDU)
C. Sensoriamento e Telemetria
Para viabilizar a ”Navegaçao Consciente de Energia”, o ˜
hardware inclui instrumentaçao espec ˜ | ífica:
- Sensores de Potencia (INA219/226, por exemplo): ˆ
Monitores de corrente/tensao de alta precis ˜ | ao conectados ˜
via barramento I2C. Eles fornecem ao ESP32-S3 os dados
em tempo real de Geraçao Solar ( ˜ | Pin) e Consumo dos

Motores (Pload), variaveis mandat ´ | orias para a funç ´ | ao de ˜
custo do algoritmo de navegaçao. ˜
- Conectividade | Wan | (4G/LTE): | Modulo | celular ´
operando via protocolo PPPoS (Point-to-Point over Serial) ou outro, permitindo que o ESP32-S3 gerencie

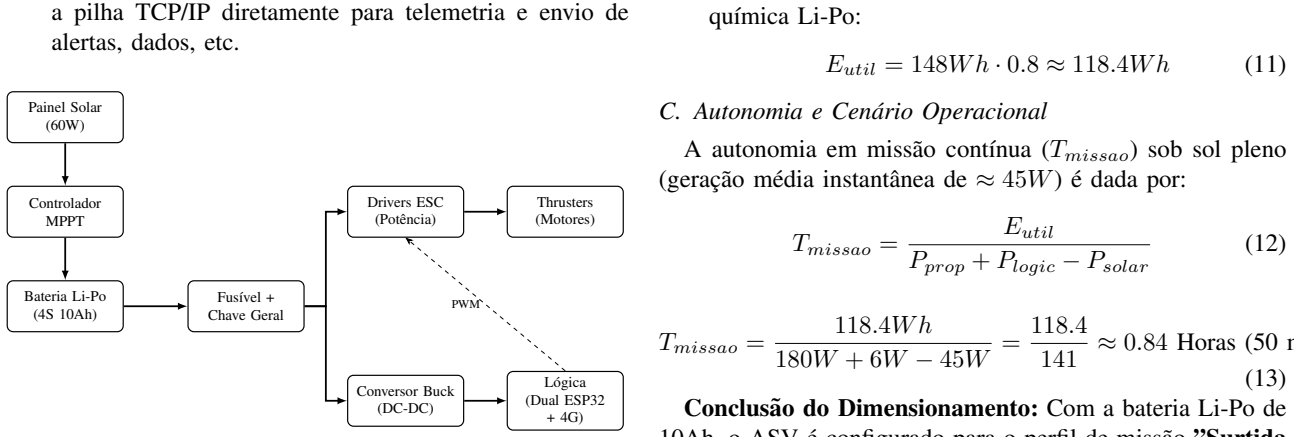
[picture p29: figure]
alertas, dados, etc.; Painel Solar (60W); Controlador MPPT; Bateria Li-Po (4S 10Ah); Fusível + Chave Geral; Drivers ESC (Potencia) ˆ; Thrusters (Motores); Conversor Buck (DC-DC); Logica ´ (Dual ESP32 + 4G); PWM; química Li-Po:; C. Autonomia e Cenario Operacional ´; Tmissao =; Eutil; Pprop + Plogic − Psolar; Conclusao do Dimensionamento: ˜; Com a bateria Li-Po de

a pilha TCP/IP diretamente para telemetria e envio de

Fig. 3: Diagrama de Blocos do Sistema de Alimentaçaõ

IV. DIMENSIONAMENTO E BALANÇ O ENERGETICO ´

O dimensionamento fundamenta-se na premissa operacional
de que o ASV atuara como um ve ´ | ículo com alimentaçaõ
híbrida. A analise quantifica a demanda de carga, a geraç ´ | aõ
estocastica e o armazenamento, ajustando a expectativa de ´
autonomia a realidade da bateria de Pol ` | ímero de Lítio (Li-
Po) selecionada por criterios de peso e pot ´ | encia espec ˆ | ífica.
A. Levantamento de Cargas e Propulsaõ
A demanda energetica ´ | e segregada em Carga L ´ | ogica e ´
Propulsao. ˜ | E crucial notar que o consumo dos motores n ´ | aõ
e fixo, mas depende do acoplamento mec ´ | anico com a ˆ | agua. ´
- Carga Logica ( ´ | Plogic): Considerando o pior caso (pro-
cessamento de IA ativo + transmissao 4G): ˜
– ESP32-S3 + Standard + Perifericos: ´ ≈ 2.5W.
– Modem 4G/LTE + Sensores: ≈ 3.5W.
– Total Logico: ´ | Plogic ≈ 6.0W.
- Carga de Propulsao ( ˜ | Pprop): Para atingir o regime
de cruzeiro rapido ( ´ | 1.5 − 2.0m/s), assume-se o uso
de helices submersas de passo fixo (di ´ | ametro estimado ˆ
35-42mm) acopladas aos motores brushless. Baseado na
curva de torque hidrodinamico ( ˆ | P ∝ v

3
):
– Ponto de Operaçao (Cruzeiro R ˜ | apido): ´ | Pprop ≈
180W.
B. Capacidade de Geraçao e Armazenamento ˜
- Geraçao Solar ( ˜ | Psolar): Painel de 60W. Considerando
a media de insolaç ´ | ao de Bras ˜ | ília (4.45 HSP) e eficiencia ˆ
sistemica de 0.8: ˆ

Eday = 60W · 4.45h · 0.8 ≈ 214W h/dia (9)

- Armazenamento (Bateria): Selecionou-se (inicialmente) um pack Li-Po 4S (14.8V Nominal) de 10.000 mAh

(10Ah). Esta escolha prioriza a reduçao de peso e alta ˜ taxa de descarga.

Etotal = 14.8V · 10Ah = 148W h | (10)

Considerando um DoD seguro de 80% para preservar a

Eutil = 148W h · 0.8 ≈ 118.4W h | (11)
A autonomia em missao cont ˜ | ínua (Tmissao) sob sol pleno
(geraçao m ˜ | edia instant ´ | anea de ˆ | ≈ 45W) e dada por: ´

(12)

≈ 0.84 Horas (50 min)
(13)
10Ah, o ASV e configurado para o perfil de miss ´ | aõ ”Surtida
Tatica” ´ | . O sistema e capaz de operar em velocidade m ´ | axima ´
por aproximadamente 50 minutos ininterruptos. Apesar da autonomia temporal reduzida em comparaçao a bancos maiores, ˜ a alta velocidade (1.8m/s) permite percorrer cerca de 5.4 km lineares neste intervalo.
Ressalta-se que, para fins de validaçao experimental e ˜ Prova de Conceito (PoC) deste trabalho, esta autonomia é superabundante. Ciclos de teste de campo para verificaçao de ˜ malhas de controle, telemetria e coleta de dados ambientais raramente excedem 15 a 20 minutos contínuos. Portanto, o dimensionamento visa oferecer uma margem de segurança igual ou superior a 100% para a realizaçao dos ensaios fun- ˜ cionais, permitindo multiplas baterias de testes ou varreduras ´ de hotspots antes de retornar a base ou entrar no modo de `
Recarga Estatica Solar ´ | para um novo ciclo.
V. ESTRATEGIA DE ´ | NAVEGAÇ AÕ CONSCIENTE DE

ENERGIA (SOFTWARE/IA)
A viabilidade de missoes de longa duraç ˜ | ao em um ASV ˜
com restriçoes de armazenamento depende da transiç ˜ | ao de ˜
um paradigma de controle estatico para uma abordagem de ´ Navegaçao Consciente de Energia. O software embarcado no ˜
ESP32-S3 nao atua apenas como piloto autom ˜ | atico, mas como ´
um gerenciador de recursos estocasticos, resolvendo em tempo ´
real o problema de otimizaçao entre o tempo de miss ˜ | ao e a ˜
sobrevivencia energ ˆ | etica. ´
A. O Problema de Otimizaçao Embarcada ˜
O objetivo do algoritmo de controle e determinar, a cada ´ ciclo de decisaõ t, a velocidade de referencia ˆ vref que deve ser enviada ao controlador de motores. Diferente de veículos terrestres onde a velocidade e ditada apenas pela via, no ASV ´
a velocidade e uma funç ´ | ao do Estado de Carga ( ˜ | SoC) e da
Irradiancia Solar ( ˆ | Psolar).
O sistema opera sob a premissa de que a potencia de ˆ propulsaõ Pprop cresce cubicamente com a velocidade (P ∝

v

3
). Portanto, pequenas reduçoes na velocidade resultam em ˜ ganhos exponenciais de autonomia. O algoritmo busca min-
imizar a Funçao de Custo ˜ | J(v) definida na fundamentaçaõ
teorica: ´

vopt = arg min
v
w1

Drest
v

+ w2e

λ(Ereserva−Eproj (v))
(14)

Esta abordagem permite que o ASV exiba comportamentos adaptativos emergentes, como reduzir a velocidade automaticamente ao entrar em zonas de sombra (nuvens) ou acelerar
quando a bateria esta plena e a insolaç ´ | aõ e m´ | axima (”Sprint ´
Solar”).
B. Maquina de Estados Finitos (FSM) de Energia ´
Para garantir determinismo e segurança operacional, a
logica de decis ´ | aõ e encapsulada em uma M ´ | aquina de Esta- ´
dos Finitos. O ESP32-S3 transita entre modos de operaçaõ baseados nas leituras dos sensores de potencia (INA219/226): ˆ
- Modo Cruzeiro (Normal Ops): (SoC > 40%). O ASV opera na velocidade planejada para a missao (ex: ˜ 1.8m/s), ajustando-se levemente conforme a geraçao so- ˜
lar instantanea para manter o balanço neutro se poss ˆ | ível.
- Modo Eco (Energy Saving): (20% < SoC < 40%). O sistema impoe um ”teto” de PWM nos motores. A ˜
velocidade e reduzida para o ponto de m ´ | axima efici ´ | encia ˆ
hidrodinamica (velocidade de arrasto m ˆ | ínimo), prior-
izando o alcance em detrimento do tempo.
- Modo Recarga Estatica (Survival): ´ | (SoC < 20%). O
”Cerebro” comanda a parada total dos motores. O sistema ´
desliga perifericos n ´ | ao essenciais (c ˜ | ameras, sensores de ˆ
alta potencia) via MOSFETs e entra em ˆ | Deep Sleep,
acordando periodicamente apenas para verificar se a bateria recuperou carga suficiente via painel solar para
retomar a missao ou retornar ˜ | a base. `
- Modo Turbo (Opportunity): (SoC > 90% e Psolar >
50W). Cenario de excedente energ ´ | etico. O sistema au- ´
toriza velocidades superiores para vencer correntes fortes ou cobrir areas maiores rapidamente, utilizando a energia ´ que seria desperdiçada (ja que a bateria estaria cheia). ´
C. Controlador Fuzzy Híbrido: Estrutura e Regras
Para mitigar as limitaçoes de limiares r ˜ | ígidos da FSM,
que poderiam causar instabilidade de comutaçao ( ˜ | chattering)
em zonas de fronteira, a ideia proposta e implementar um ´ controlador baseado em Logica Fuzzy do tipo Mamdani. O ´ sistema processa a incerteza inerente a variabilidade solar e `
ao estado da bateria atraves de tr ´ | es etapas fundamentais: ˆ
1) Fuzzificaçao e Vari ˜ | aveis Lingu ´ | ísticas: As variaveis de ´
entrada Crisp sao mapeadas em conjuntos fuzzy atrav ˜ | es de ´
funçoes de pertin ˜ | encia ( ˆ | µ(x)) triangulares e trapezoidais,
escolhidas pela baixa complexidade computacional para o ESP32:
- Estado de Carga (SoC): Universo de discurso [0, 100]%.
Termos: Crítico, Baixo, Medio, Pleno ´ | .
- Irradiancia Solar ( ˆ | Psol): Universo de discurso [0, 60]W.
Termos: Sombra, Nublado, Ensolarado.
- Saída (Urgencia): ˆ | Universo [0, 1]. Termos: Economia,
Normal, Performance.
2) Base de Regras e Inferencia: ˆ | O nucleo de decis ´ | ao reside ˜
na Matriz de Associaçao Fuzzy (Tabela II), que estabelece ˜
a relaçao causal entre as entradas e o modo de operaç ˜ | aõ
desejado. O motor de inferencia utiliza o m ˆ | etodo ´ | Max-Min
para agregaçao. ˜

TABLE II: Matriz de Regras Fuzzy (SoC x Solar)

SoC \Solar | Sombra | Nublado | Ensolarado
Crítico | Recarga | Recarga | Recarga
Baixo | Eco | Eco | Cruzeiro
Medio ´ | Eco | Cruzeiro | Cruzeiro
Pleno | Cruzeiro | Cruzeiro | Turbo

Note que a regra (Baixo, Ensolarado) → Cruzeiro exemplifica a vantagem sobre a histerese classica: o sistema ”autoriza” ´ maior velocidade mesmo com bateria baixa, aproveitando a energia solar instantanea que seria desperdiçada. ˆ

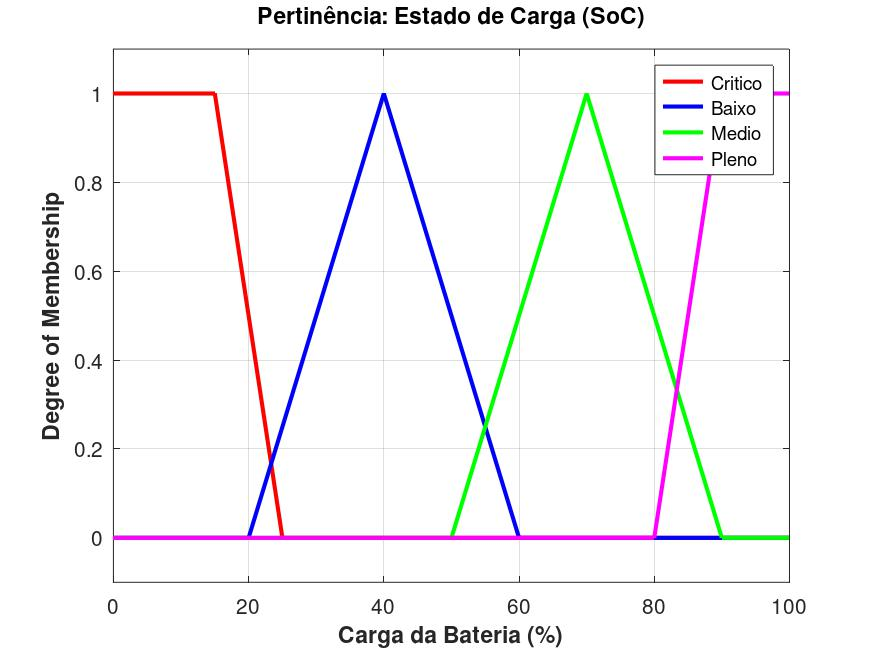
[picture p30: figure]
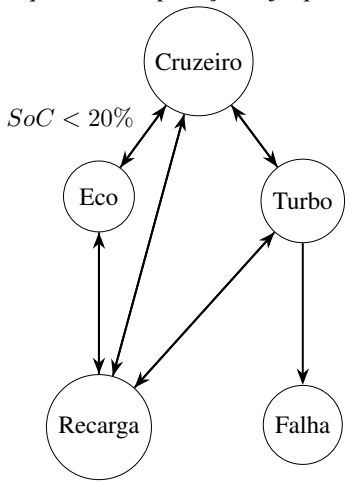
[picture p31: figure]
Cruzeiro; Eco; Turbo; Recarga; Falha; SoC < 20%

Fig. 4: Pertinencia: Estado de Carga (SoC) ˆ

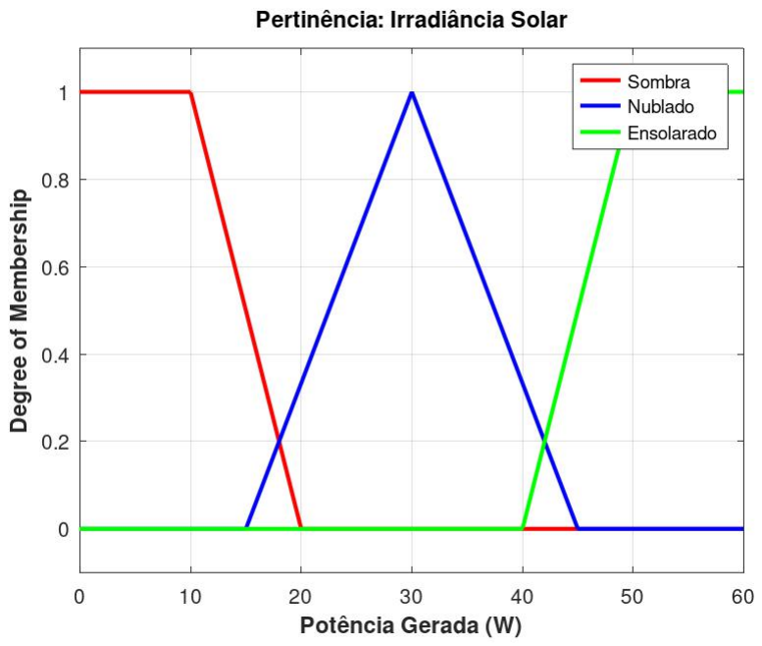
[picture p32: figure]

Fig. 5: Pertinencia: Irradi ˆ | ancia Solar ˆ

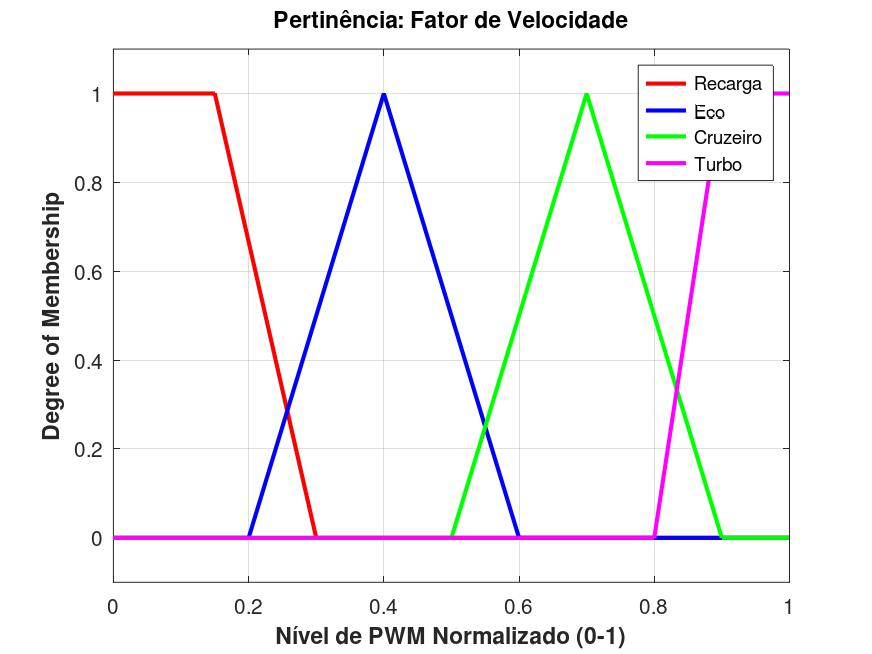
[picture p33: figure]

Fig. 6: Pertinencia: Fator de Velocidade ˆ

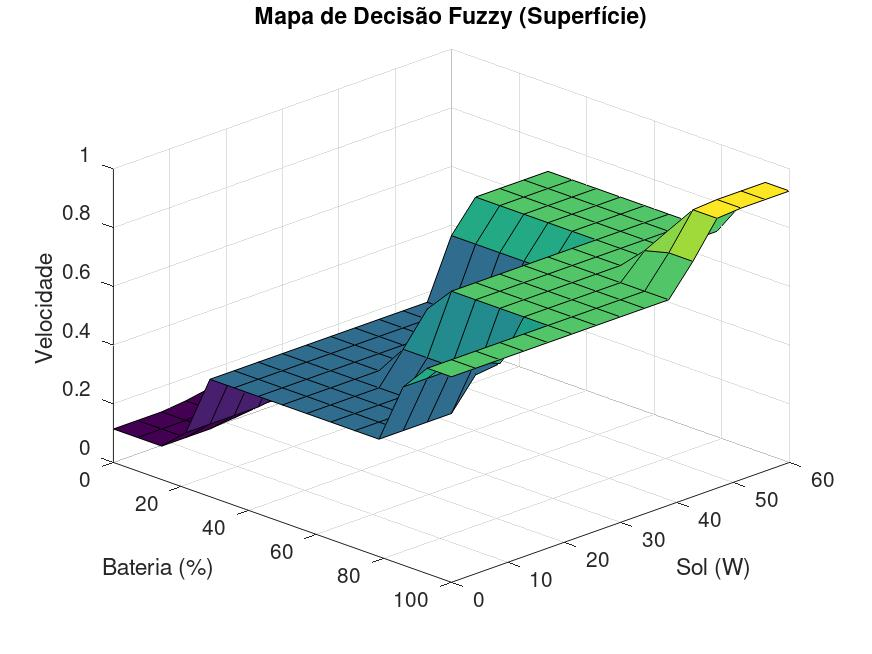
[picture p34: figure]

Fig. 7: Mapa de Decisao Fuzzy (Superf ˜ | ície)
3) Defuzzificaçao e Interface com FSM: ˜ | A saída difusa
resultante e convertida em um valor num ´ | erico discreto (Crisp) ´
utilizando o metodo do ´ | Centroide (Centro de Gravidade -
CoG):

yout =

R
µA(x) · x dx
R
µA(x) dx

(15)

Este valor normalizado yout ∈ [0, 1] atua como um coe-
ficiente de ponderaçao na M ˜ | aquina de Estados, suavizando ´
as transiçoes de PWM dos motores e definindo o ˜ | setpoint
dinamico de velocidade ( ˆ | vref ) enviado ao controlador PID.
D. Implementaçao e Comunicaç ˜ | ao Inter-Processador ˜
A arquitetura de software utiliza o RTOS (Real-Time Operating System) do ESP-IDF. A tarefa de gestao de energia ˜ executa em baixa prioridade, atualizando os calculos a cada ´ 10 segundos para filtrar ruídos transitorios de leitura. ´
Uma vez calculado o novo setpoint de velocidade, o ESP32-S3 (Cerebro) o transmite para o ESP32 Standard (Controlador) ´
atraves do protocolo IPC ( ´ | Inter-Processor Communication) via
UART:
- Protocolo Binario: ´ Utiliza-se um frame estruturado com Header, Command ID, Payload (Velocidade/Modo) e CRC32.
- Segurança (Fail-Safe): O ESP32 Standard implementa um Watchdog de comunicaçao. Se o S3 deixar de enviar ˜ comandos de velocidade (travamento por erro de IA ou Loop), o Controlador assume o estado ”Parada Segura” automaticamente apos 2 segundos. ´
Esta separaçao garante que a l ˜ | ogica complexa e proba- ´
bilística da otimizaçao energ ˜ | etica nunca comprometa a esta- ´
bilidade imediata do controle dos motores.

VI. SISTEMA DE CONTROLE E MODELAGEM DINAMICA ˆ

A simples aplicaçao de um sinal PWM em malha aberta n ˜ | | | aõ
garante a velocidade de cruzeiro desejada, visto que o sistema
esta sujeito a dist ´ | urbios externos (correntes, ventos) e internos ´
(variaçao da tens ˜ | ao da bateria ˜ | Vbat conforme a descarga). Para
garantir a estabilidade e o rastreamento preciso do setpoint definido pela IA, projeta-se um sistema de controle em malha fechada (Feedback Control).
A. Modelagem da Planta (Motor + Casco)
Para fins de projeto do controlador, o sistema de propulsaõ pode ser aproximado por um sistema de primeira ordem. A
relaçao entre a tens ˜ | ao aplicada ao motor ( ˜ | u(t)) e a velocidade
angular da helice ( ´ | ω(t)) e descrita pela equaç ´ | ao diferencial: ˜
| Jω˙(t) + Bω(t) = Ktu(t) − τload | | (16)
Onde J e o momento de in ´ | ercia do conjunto rotor-h ´ | elice, ´ | B
e o coeficiente de atrito viscoso, ´ | Kt e a constante de torque do ´
motor e τload e o torque de carga imposto pela ´ | agua (arrasto). ´
Aplicando a Transformada de Laplace e linearizando em
torno do ponto de operaçao, obtemos a Funç ˜ | ao de Trans- ˜
ferencia da Planta ˆ | Gp(s):

Gp(s) = Ω(s)
U(s)

=

K
τs + 1

(17)

Onde K e o ganho est ´ | atico do sistema (RPM/Volt) e ´ | τ é
a constante de tempo mecanica (tempo para atingir 63,2% da ˆ velocidade final).
B. Arquitetura de Controle PID
Para compensar os erros de regime estacionario e re- ´ jeitar disturbios, implementa-se um controlador Proporcional- ´ Integral-Derivativo (PID) digital no ESP32 Standard. A lei de controle no domínio do tempo e dada por: ´

u(t) = Kpe(t) + Ki

Z t

0

e(τ )dτ + Kd

de(t)
dt | (18)

Onde o erro e(t) e a diferença entre a Velocidade Desejada ´ (SetP oint) e a Velocidade Real medida (F eedback).

C. Estrategia de Implementaç ´ | ao (Malha Fechada) ˜
O sistema operara em uma malha de realimentaç ´ | ao negativa ˜
onde:
1) Sensor (Feedback): A velocidade real e obtida atrav ´ | es´
da telemetria do ESC (rotaçao el ˜ | etrica) ou via GPS ´
(velocidade de fundo), dependendo da malha de controle ativa.
2) Comparador: O ESP32 calcula o erro e[k] = SP[k] − P V [k].
3) Controlador: O algoritmo PID processa o erro e ajusta o Duty Cycle do PWM.
4) Atuador: O driver ESC modula a potencia entregue ao ˆ motor Brushless.
Esta abordagem assegura que, mesmo que a tensao da ˜ bateria caia de 16.8V para 14.0V (no caso de Li-Po 4S) ou de 13.4V para 12.0V (LiFePO4), o controlador aumentará automaticamente o duty cycle para manter a velocidade con-
stante, garantindo a previsibilidade necessaria para o c ´ | alculo ´
de autonomia da IA.

VII. CONFIABILIDADE E SEGURANÇ A (FAIL-SAFE)
A operaçao de um ve ˜ | ículo autonomo em ambiente aqu ˆ | atico ´
impoe riscos severos de perda de equipamento. Para mitigar ˜
falhas catastroficas, a seguir est ´ | ao algumas sugest ˜ | oes propostas ˜
para o sistema implementar camadas de proteçao baseadas em ˜ defesa em profundidade:
A. Proteçoes El ˜ | etricas e T ´ | ermicas ´
- Monitoramento Termico Ativo: ´ | Sensores NTC acopla-
dos a bateria e aos drivers de motor. Caso a temper- ` atura exceda 60◦C (limite seguro da Li-Po/LiFePO4), o ESP32 Standard entra em modo de Derating, reduzindo a potencia dos motores em 50% ou desligando-os total- ˆ mente para resfriamento.
- Proteçao de Sobrecorrente: ˜ | Fusíveis automotivos na
linha de potencia principal e monitoramento de corrente ˆ via software (INA219). Se um motor travar (algas na
helice), o pico de corrente ´ | e detectado em ´ | < 100ms e o
driver e desabilitado antes da queima do enrolamento. ´
B. Watchdogs e Recuperaçao (Software) ˜
- Dual Watchdog Timer (WDT): Tanto o ESP32-S3 quanto o Standard possuem WDTs de hardware ativados. Se o firmware travar, o chip reinicia automaticamente em 3 segundos.
- Dead Man’s Switch (Link de Comunicaçao): ˜ Se o ASV perder conexao com a base (4G ou Telemetria) por ˜ mais de Ttimeout (ex: 5 minutos), ele aborta a missao e ˜
entra em modo ”Retorno a Base” (RTL) usando a ` | ultima ´
coordenada GPS segura conhecida.
C. Proteçao Mec ˜ | anica e Estanqueidade ˆ
- Sensor de umidade/agua interno no compartimento ´
eletronico. Detecç ˆ | ao de vazamento aciona envio imediato ˜
de alerta de socorro e desligamento dos circuitos de alta
potencia (Motores) para evitar eletr ˆ | olise e curto-circuito. ´

VIII. METODOLOGIA DE VALIDAÇ AÕ
Para garantir a robustez, o projeto preve tr ˆ | es est ˆ | agios de ´
validaçao: ˜
1) Simulaçao Num ˜ | erica: ´ | Modelagem da funçao de custo ˜
em Python/Matlab/Entre outros sob cenarios de ir- ´
radiancia hist ˆ | orica de Bras ´ | ília.
2) Hardware-in-the-Loop (HIL): Bancada de testes onde o ESP32 controla os motores físicos, mas a carga hidrodinamica ˆ e simulada eletronicamente. ´
3) Testes de Campo: Telemetria em tempo real no Lago
Paranoa ou similar para validaç ´ | ao do modelo de con- ˜
sumo energetico. ´

IX. LISTA DE MATERIAIS E CONCLUSAÕ
A pesquisa teorica culminou na definiç ´ | ao da seguinte ˜ | Bill
of Materials (BOM) preliminar para a validaçao do prot ˜ | otipo: ´

TABLE III: Lista de Materiais Críticos do Subsistema de Energia

Subsistema | Componente | Especificaçao Chave ˜
Geraçaõ | Painel Solar Flexível | 60W / 18V Monocristalino
Armazenamento | Bateria (Definida) | Li-Po 4S 10Ah
Regulaçaõ | Controlador MPPT | Compatível com Lítio, η > 95%
Propulsaõ | 2x Motores Brushless | 800-1000kV (Submersíveis)
Controle | ESP32-S3 + Standard | Dual-Core Heterogeneo ˆ
Sensoriamento | Modulo GPS + INA226 ´ | Navegaçao e Telemetria de Energia ˜
A. Conclusaõ
Este documento formalizou as bases físicas e matematicas ´
para o desenvolvimento do sistema de alimentaçao do ASV. ˜
A analise demonstrou que a simples integraç ´ | ao de com- ˜
ponentes naõ | e suficiente; ´ | e necess ´ | aria uma abordagem ´
sistemica que une a ˆ | Eletroquímica (na escolha da bateria),
a Hidrodinamica ˆ | (na modelagem de carga cubica) e a ´ | Teoria
de Controle Otimo ´ | (na gestao de energia via IA). ˜
Conclui-se que a arquitetura híbrida proposta, operando
sob o algoritmo de navegaçao consciente de energia, ˜ | e capaz ´
de estender a autonomia operacional do veículo para alem´
dos limites de uma bateria estatica, viabilizando miss ´ | oes ˜
de monitoramento ambiental contínuo no corpo hídrico com
níveis satisfatorios de robustez e efici ´ | encia. ˆ

REFERENCES

[1] T. I. Fossen, ”Handbook of Marine Craft Hydrodynamics and Motion Control”, John Wiley & Sons, 2011.
[2] J. Rabaey, ”Digital Integrated Circuits: A Design Perspective”, 2nd Edition (2003).
[3] Manual de Engenharia para Sistemas Fotovoltaicos, CEPEL, 2014.
[4] Linden, D., Reddy, T. B. (2010). Handbook of Batteries.
[5] Rashid, M. H. (2017). Power Electronics Handbook.
[6] Enio B. P., Fernando R M e Outros. Atlas brasileiro de energia solar 2.ed. Sao Jos ˜ e dos Campos : INPE, (2017). ´
