AlphaCompLabs/H-Drop/Docs/WhatsApp Image 2026-03-01 at 10.31.07.jpeg

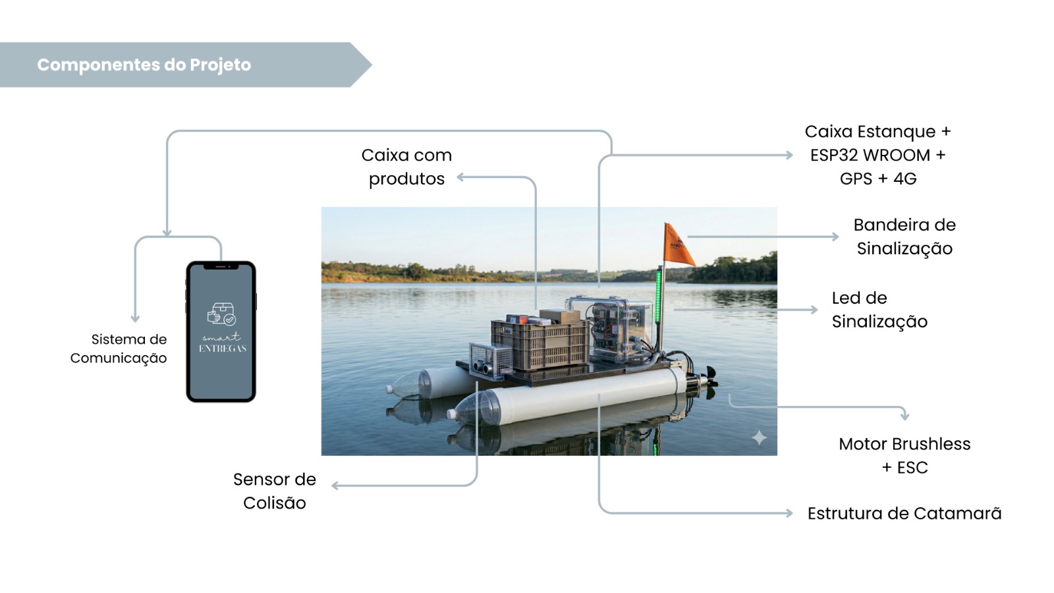
Docs/WhatsApp Image 2026-03-01 at 10.31.07.jpeg
