AlphaCompLabs/H-Drop/PC4/Imagens e LIB/foto_prototipo_piscina.jpeg

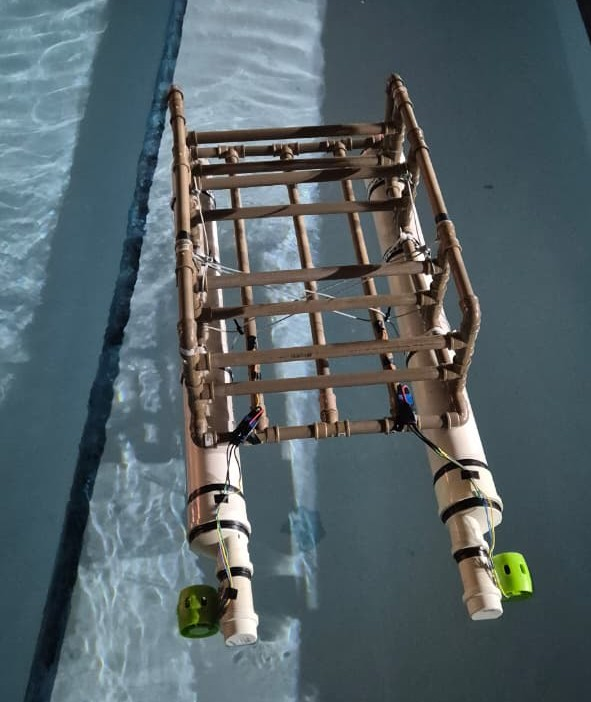
PC4/Imagens e LIB/foto_prototipo_piscina.jpeg
