AlphaCompLabs/H-Drop/PC4/Imagens e LIB/foto_prototipo_proa.jpeg

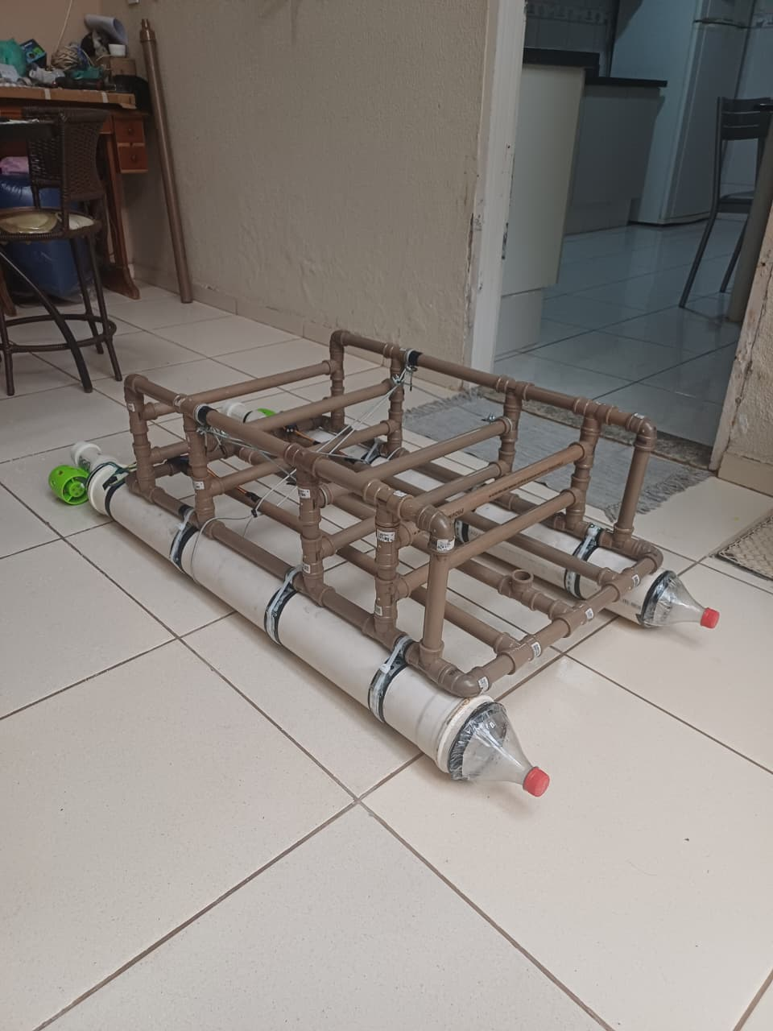
PC4/Imagens e LIB/foto_prototipo_proa.jpeg
