AlphaCompLabs/H-Drop/(commit log)

2026-04-19 feat: add sidebar component for displaying telemetry and destination information
    feat: create sync test component for mission control commands and logging
    style: add styles for sync test component
    feat: implement alert overlay component for critical alerts and notifications
    style: add styles for alert overlay component
    feat: create compass component for displaying magnetic heading
    style: add styles for compass component
    feat: implement status bar component to show system status indicators
    style: add styles for status bar component
    feat: create telemetry card component for displaying telemetry data
    style: add styles for telemetry card component
    feat: add theme toggle component for s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
2026-04-19 feat: add central button for map positioning and create .gitignore for backend
2026-04-29 ADD: SENSOR E GPS FILES
2026-04-30 feat: adicionando codigo sensor
